javadtaghia/cece-the-robot/fun designs/samsung_t5_monitor_holder/T5_Left_Mount_Provisional.png

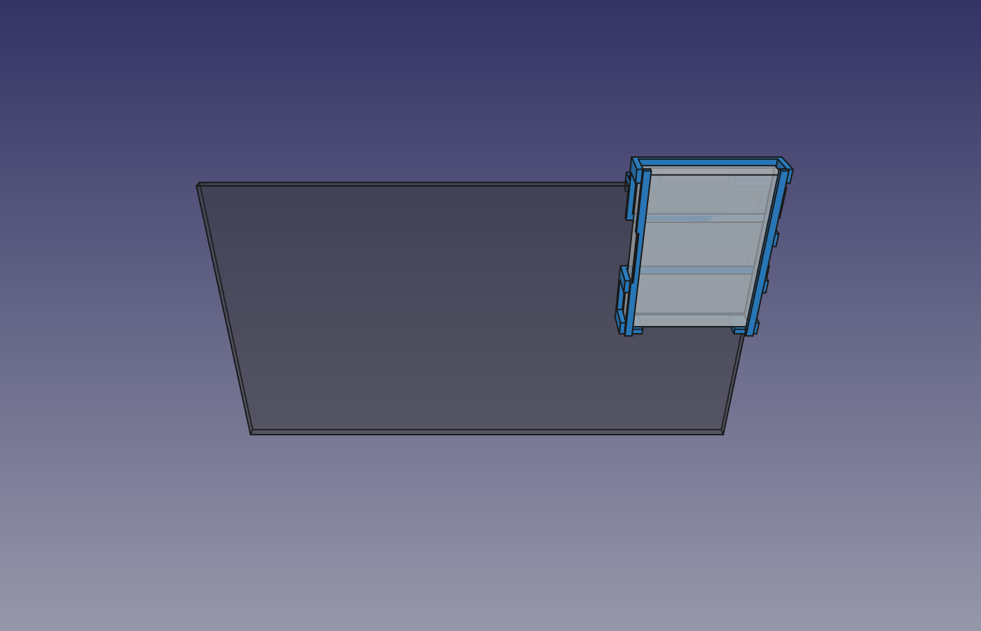
fun designs/samsung_t5_monitor_holder/T5_Left_Mount_Provisional.png
