javadtaghia/cece-the-robot/fun designs/samsung_t5_monitor_holder/T5_One_Piece_4_Hooks_Preview.png

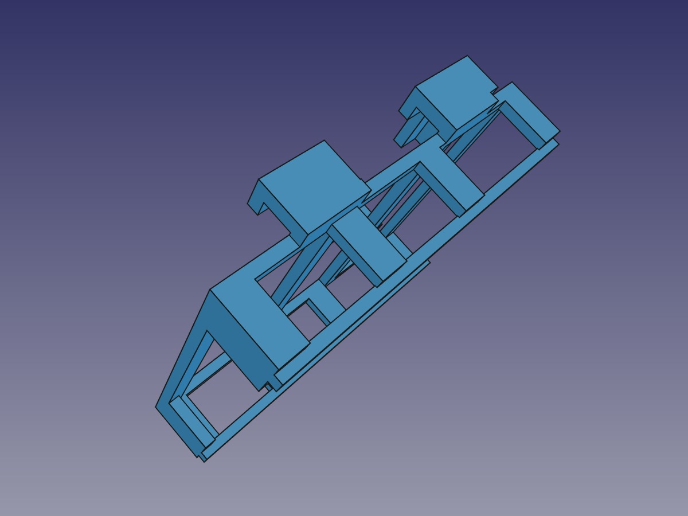
fun designs/samsung_t5_monitor_holder/T5_One_Piece_4_Hooks_Preview.png
