javadtaghia/cece-the-robot/fun designs/README.md

# Fun designs

- [Samsung T5 one-piece MacBook holder](samsung_t5_monitor_holder/README.md) — lightweight prototype with two loose side hooks and two top hooks. Real-laptop fit and load are unverified.
