javadtaghia/cece-the-robot/archive/workspace/piicodev_servo_ref/README.md

# PiicoDev® Servo Driver

This is the repo for the Core Electronics [PiicoDev Servo Driver](https://core-electronics.com.au/catalog/product/view/sku/CE09181) PCB project.

## License
This project is open source - please review the LICENSE.md file for further licensing information.

If you have any technical questions, or concerns about licensing, please contact technical support on the [Core Electronics forums](https://forum.core-electronics.com.au/).

*\"PiicoDev\" and the PiicoDev logo are trademarks of Core Electronics Pty Ltd.*
