javadtaghia/cece-the-robot/experiments/cece2/Cece2_Assembly.FCStd

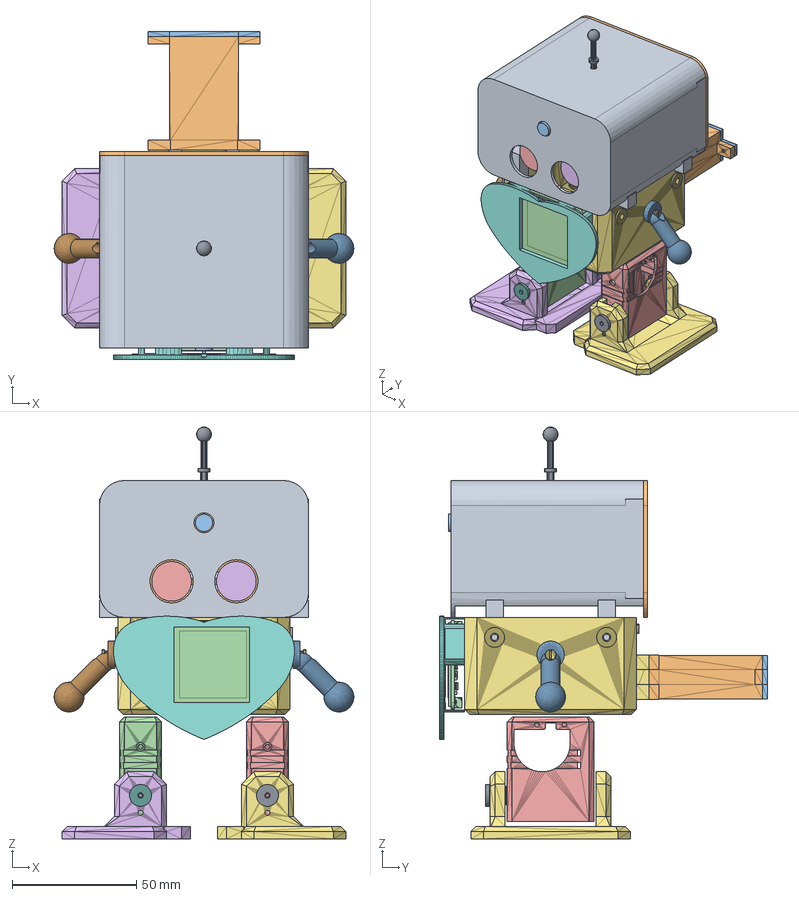
[picture p3: CAD file, 2026-11-01]
experiments/cece2/Cece2_Assembly.FCStd
120.4 x 131.7 x 165.5 mm
Rounded_Head_Study
Rear_Cover_Study
Camera_Lens_Corridor_Provisional
OLED_Adafruit4741_Official_CAD
HC_SR04_Left_Can
HC_SR04_Right_Can
Heart Frame V4 candidate
Antenna
Left_Arm
Right_Arm
Left_Leg
Right_Leg
Left_Foot
Right_Foot
Left_Washer
Right_Washer
Charger_Tray
Charger_Bezel
