javadtaghia/cece-the-robot/experiments/cece/esp_head_carrier/Cece_Head_ESP_Assembly_R10.FCStd

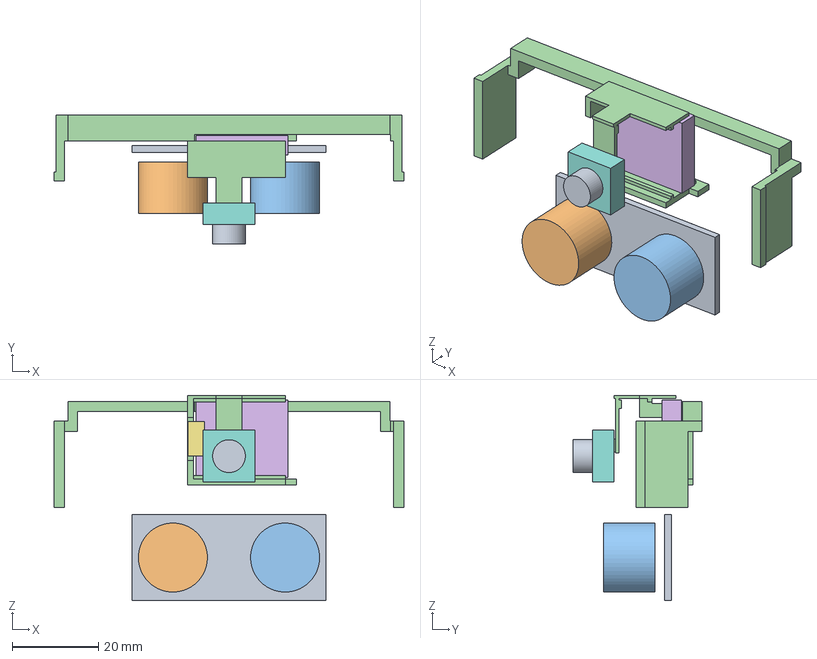
[picture p6: CAD file, 2026-11-11]
experiments/cece/esp_head_carrier/Cece_Head_ESP_Assembly_R10.FCStd
81.1 x 29.8 x 47.6 mm
HC_SR04_PCB
HC_SR04_Left_Can
HC_SR04_Right_Can
Cece R10 carrier - 2 mm deeper, central ridge flush
Camera housing contact pad - 0.20 mm provisional preload
ESP PCB - internal layout provisional
ESP USB Socket - internal layout provisional
ESP Camera Housing - internal layout provisional
ESP Camera Lens - internal layout provisional
