javadtaghia/cece-the-robot/experiments/cece/esp_head_carrier/Cece_Head_ESP_Assembly_R11.FCStd

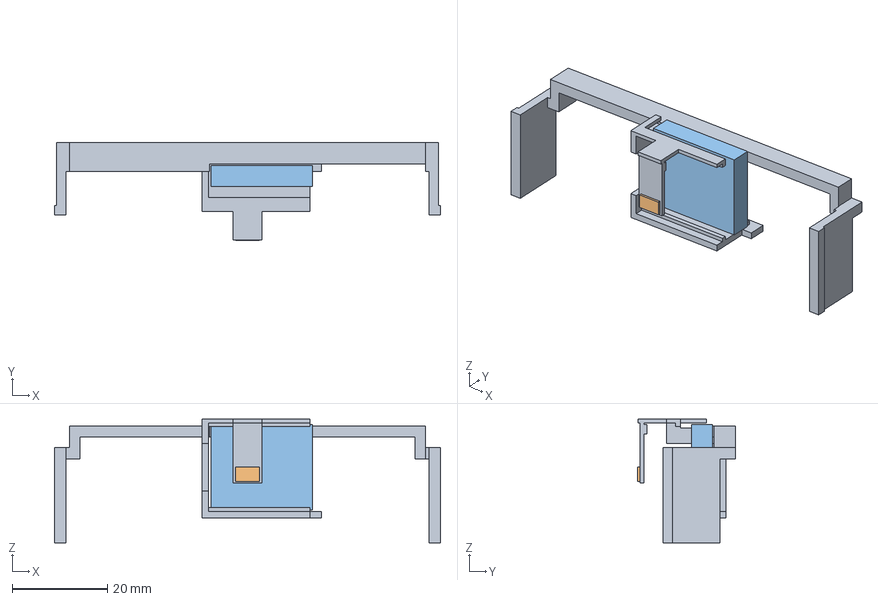
[picture p7: CAD file, 2026-11-11]
experiments/cece/esp_head_carrier/Cece_Head_ESP_Assembly_R11.FCStd
81.1 x 20.5 x 26.0 mm
Cece R11 carrier - open pin access above board
Camera housing contact pad - 0.20 mm provisional preload
ESP PCB - internal layout provisional
