javadtaghia/cece-the-robot/fun designs/samsung_t5_monitor_holder/Samsung_T5_Holder_Assembly_PROVISIONAL.FCStd

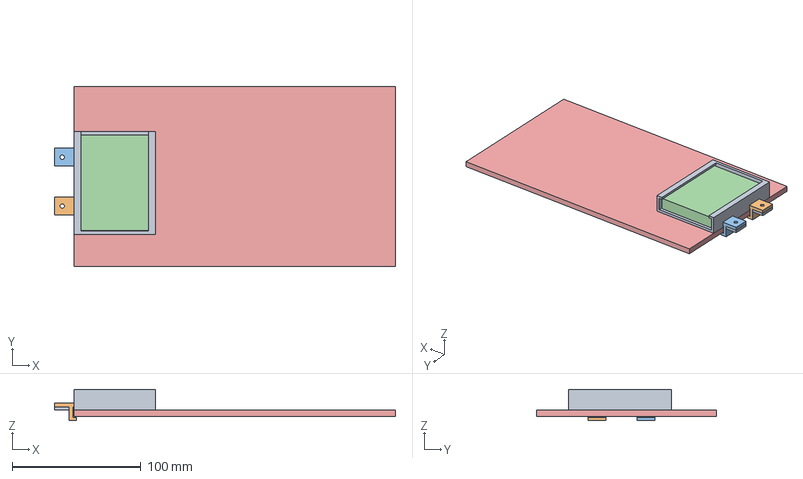
[picture p8: CAD file, 2026-10-31]
fun designs/samsung_t5_monitor_holder/Samsung_T5_Holder_Assembly_PROVISIONAL.FCStd
265.0 x 140.0 x 24.1 mm
Holder_print_one
Hook_lower_print_one
Hook_upper_print_one
SSD_envelope_reference_only
Monitor_envelope_reference_only
