javadtaghia/cece-the-robot/experiments/cece/esp_head_carrier/Cece_Head_ESP_Assembly_R15.FCStd

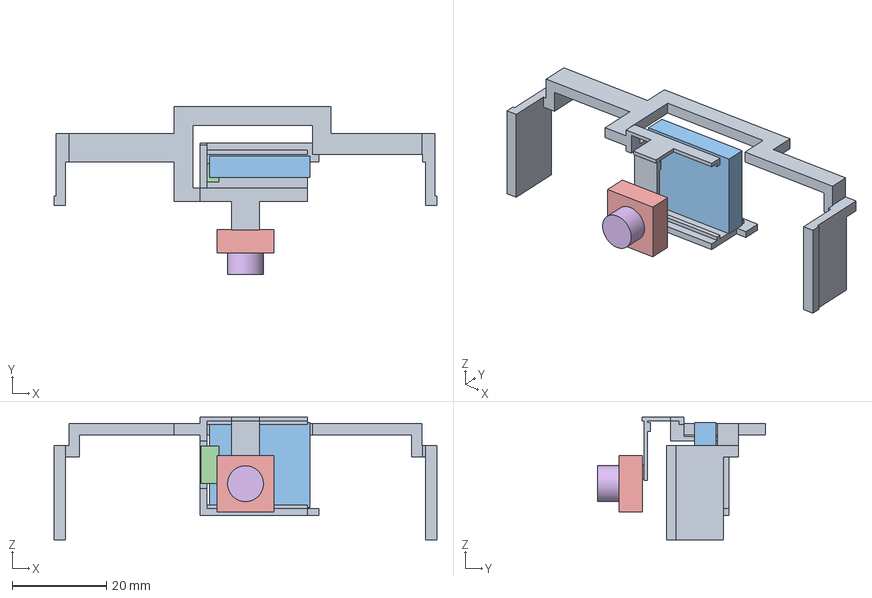
[picture p9: CAD file, 2026-11-11]
experiments/cece/esp_head_carrier/Cece_Head_ESP_Assembly_R15.FCStd
81.1 x 35.5 x 26.0 mm
Cece R15 carrier - screenshot-right shoulder shifted 3 mm
Camera housing contact pad - 0.20 mm provisional preload
ESP PCB - internal layout provisional
ESP USB Socket - internal layout provisional
ESP Camera Housing - internal layout provisional
ESP Camera Lens - internal layout provisional
