javadtaghia/cece-the-robot/experiments/cece/esp_head_carrier/Cece_Head_ESP_Assembly_R9.FCStd

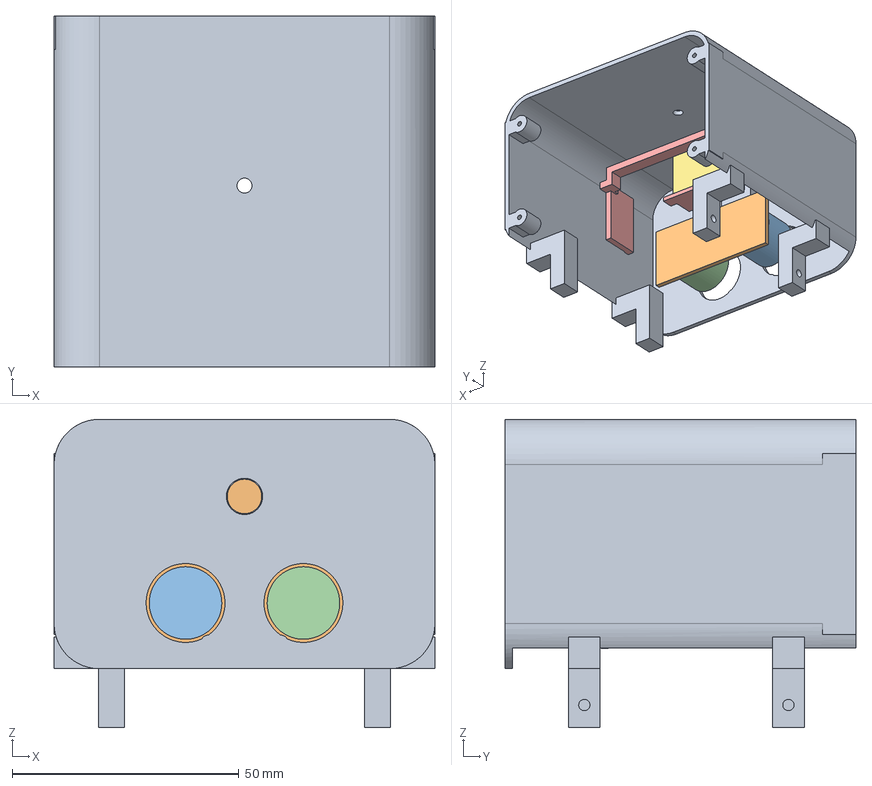
[picture p10: CAD file, 2026-11-11]
experiments/cece/esp_head_carrier/Cece_Head_ESP_Assembly_R9.FCStd
84.0 x 77.4 x 68.0 mm
Rounded_Head_Study
HC_SR04_PCB
HC_SR04_Left_Can
HC_SR04_Right_Can
Cece USB-first carrier - solid wall supports and camera flap
Camera housing contact pad - 0.20 mm provisional preload
ESP PCB - internal layout provisional
ESP USB Socket - internal layout provisional
ESP Camera Housing - internal layout provisional
ESP Camera Lens - internal layout provisional
