javadtaghia/cece-the-robot/experiments/cece/esp_head_carrier/Cece_Head_ESP_Assembly_R16.FCStd

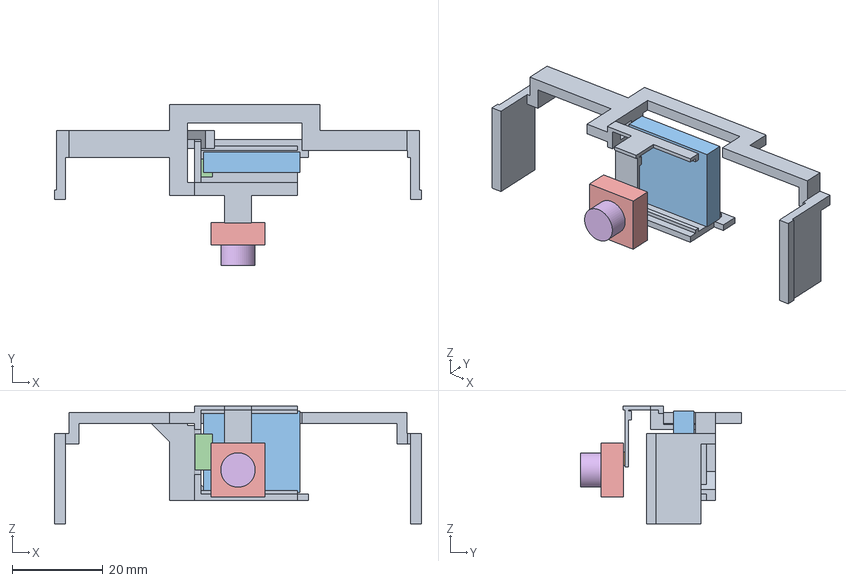
[picture p12: CAD file, 2026-11-08]
experiments/cece/esp_head_carrier/Cece_Head_ESP_Assembly_R16.FCStd
81.1 x 35.5 x 26.0 mm
Cece R16 carrier - reinforced USB-end upright
Camera housing contact pad - 0.20 mm provisional preload
ESP PCB - internal layout provisional
ESP USB Socket - internal layout provisional
ESP Camera Housing - internal layout provisional
ESP Camera Lens - internal layout provisional
