javadtaghia/cece-the-robot/experiments/cece/esp_head_carrier/Cece_Head_ESP_Assembly_R12.FCStd

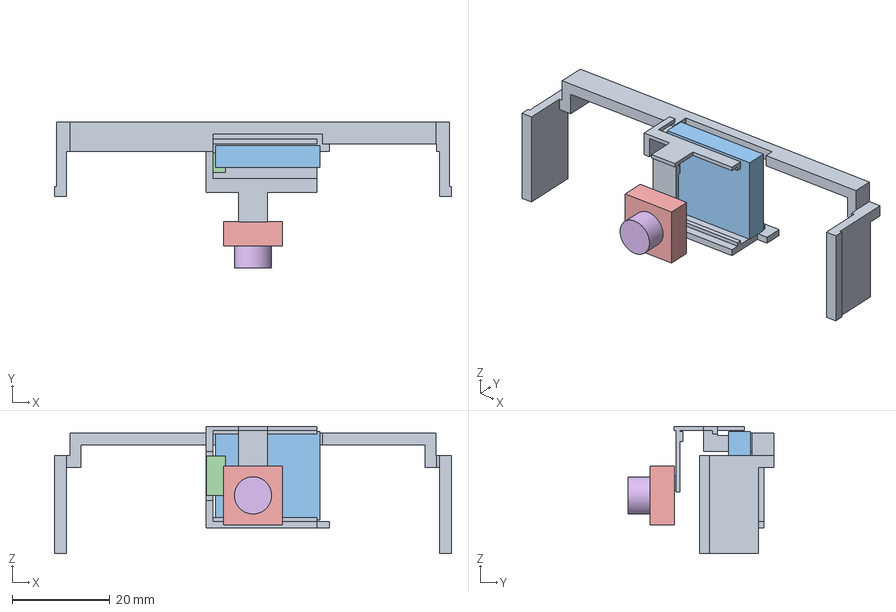
[picture p13: CAD file, 2026-11-08]
experiments/cece/esp_head_carrier/Cece_Head_ESP_Assembly_R12.FCStd
81.1 x 29.8 x 26.0 mm
Cece R12 carrier - ledge removed behind board edge
Camera housing contact pad - 0.20 mm provisional preload
ESP PCB - internal layout provisional
ESP USB Socket - internal layout provisional
ESP Camera Housing - internal layout provisional
ESP Camera Lens - internal layout provisional
