javadtaghia/cece-the-robot/experiments/cece/esp_head_carrier/Cece_Head_ESP_Assembly_R4.FCStd

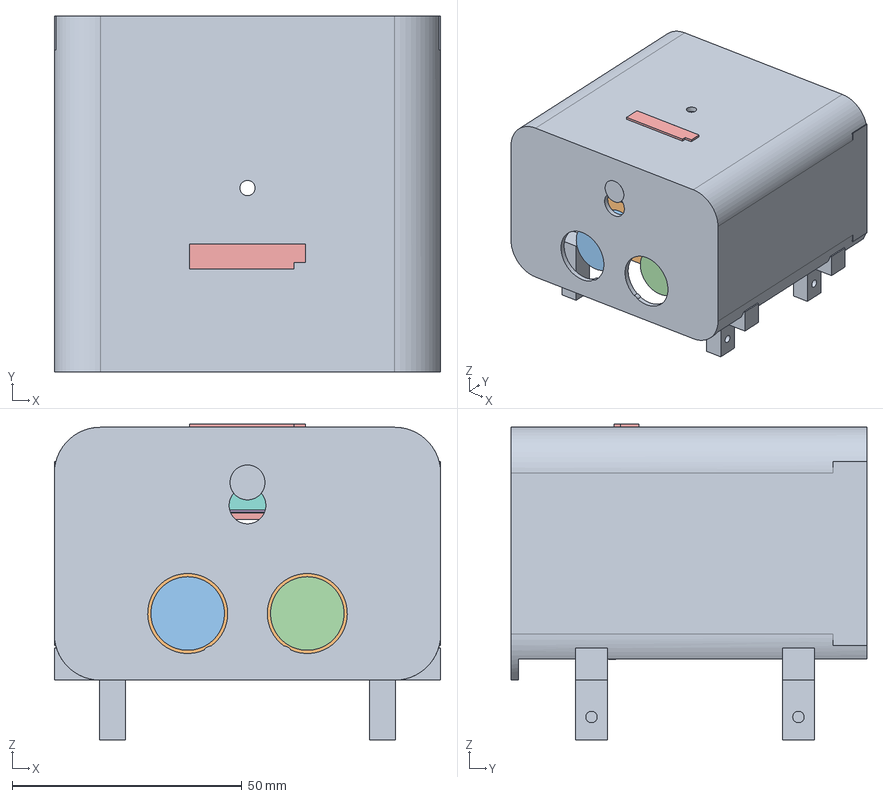
[picture p14: CAD file, 2026-11-08]
experiments/cece/esp_head_carrier/Cece_Head_ESP_Assembly_R4.FCStd
84.0 x 77.4 x 68.7 mm
Rounded_Head_Study
HC_SR04_PCB
HC_SR04_Left_Can
HC_SR04_Right_Can
Cece ESP carrier - reaches both inner side walls
ESP PCB - internal layout provisional
ESP USB Socket - internal layout provisional
ESP Camera Housing - internal layout provisional
ESP Camera Lens - internal layout provisional
REVIEW - raised carrier intersects current head
REVIEW - ESP Camera Lens intersects current head
