javadtaghia/cece-the-robot/experiments/cece/esp_head_carrier/Cece_Head_ESP_Assembly.FCStd

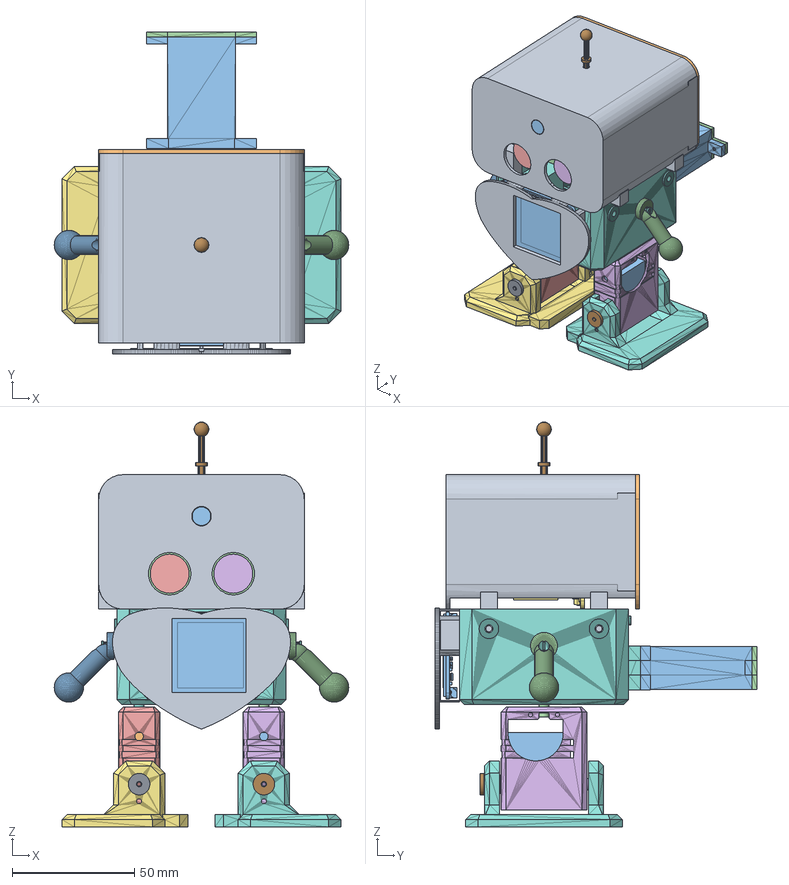
[picture p15: CAD file, 2026-11-07]
experiments/cece/esp_head_carrier/Cece_Head_ESP_Assembly.FCStd
120.4 x 131.7 x 165.5 mm
Rounded_Head_Study
Rear_Cover_Study
OLED_Adafruit4741_Official_CAD
HC_SR04_PCB
HC_SR04_Left_Can
HC_SR04_Right_Can
PiicoDev_Driver_Official_Partial_STEP
Left_Hip_SG90_Proxy
Right_Hip_SG90_Proxy
Left_Ankle_SG90_Proxy
Right_Ankle_SG90_Proxy
SG90_Mated_Plug_1_Proxy
SG90_Mated_Plug_2_Proxy
SG90_Mated_Plug_3_Proxy
SG90_Mated_Plug_4_Proxy
Heart Frame V4 candidate
Antenna
Left_Arm
Right_Arm
Left_Leg
Right_Leg
Left_Foot
Right_Foot
Left_Washer
Right_Washer
Charger_Tray
Charger_Bezel
Charger_UC2_Unpurchased_Proxy
Perfboard_Provisional_30x20
Left_Hip_Turret_Proxy
Left_Hip_Output_Shaft_Proxy
Left_Ankle_Turret_Proxy
Left_Ankle_Output_Shaft_Proxy
Right_Hip_Turret_Proxy
Right_Hip_Output_Shaft_Proxy
Right_Ankle_Turret_Proxy
Right_Ankle_Output_Shaft_Proxy
Cece ESP carrier - reaches both inner side walls
ESP PCB - internal layout provisional
ESP USB Socket - internal layout provisional
ESP Camera Housing - internal layout provisional
ESP Camera Lens - internal layout provisional
