javadtaghia/cece-the-robot/experiments/cece/esp_head_carrier/Cece_ESP_Side_Carrier_R14_PREVIEW.stl

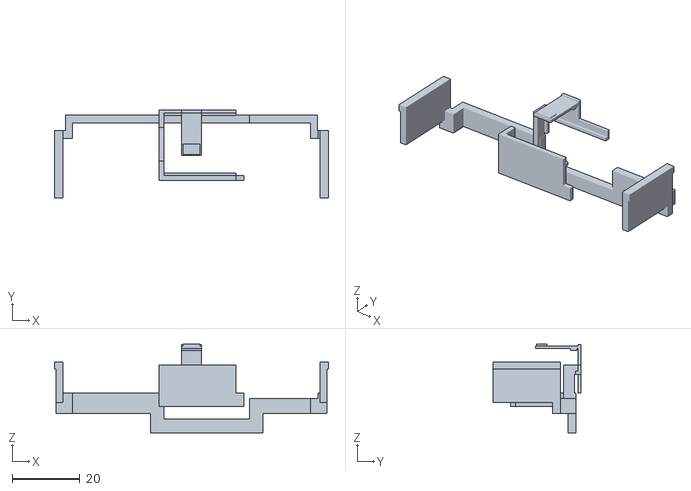
[picture p16: CAD file, 2026-11-11]
experiments/cece/esp_head_carrier/Cece_ESP_Side_Carrier_R14_PREVIEW.stl
81.1 x 26.0 x 26.2
