javadtaghia/cece-the-robot/fun designs/samsung_t5_monitor_holder/Samsung_T5_One_Piece_Prototype.FCStd

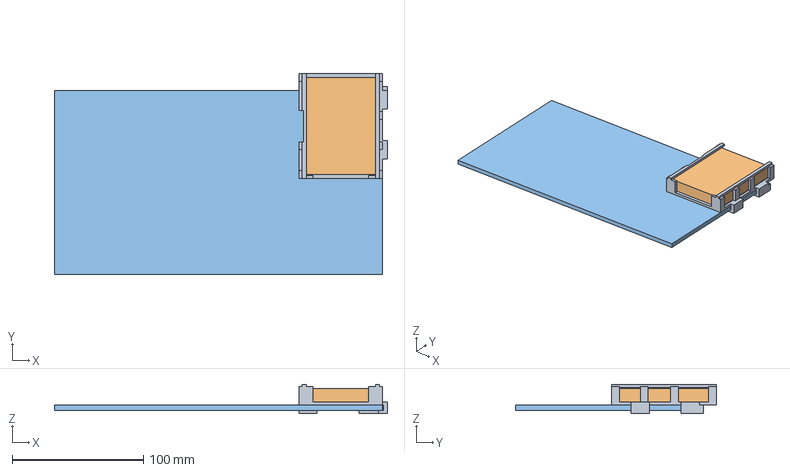
[picture p17: CAD file, 2026-11-07]
fun designs/samsung_t5_monitor_holder/Samsung_T5_One_Piece_Prototype.FCStd
253.8 x 153.0 x 22.3 mm
Holder_one_piece_PRINT
SSD_reference_do_not_print
Lid_reference_do_not_print
