javadtaghia/cece-the-robot/fun designs/samsung_t5_monitor_holder/T5_One_Piece_Holder_PROTOTYPE.3mf

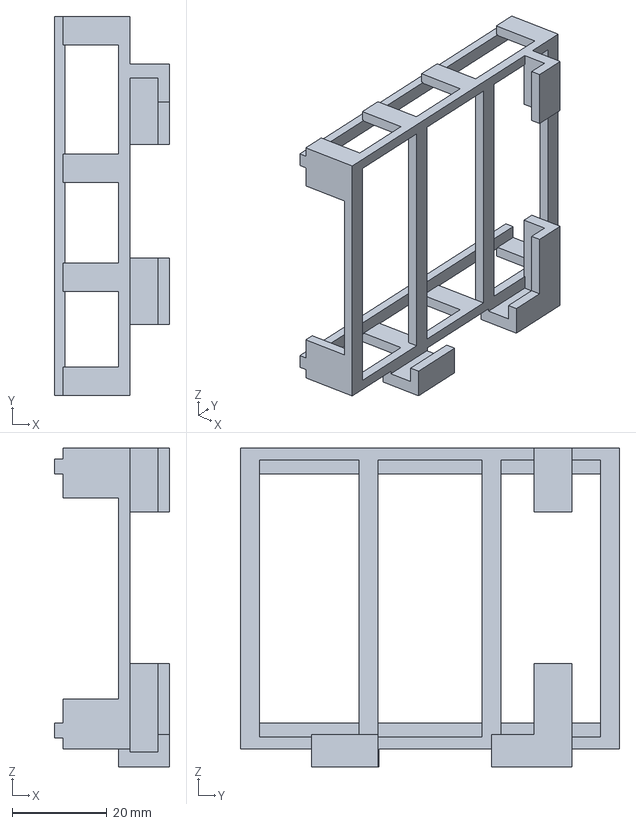
[picture p18: CAD file, 2026-10-31]
fun designs/samsung_t5_monitor_holder/T5_One_Piece_Holder_PROTOTYPE.3mf
24.3 x 80.0 x 67.3 mm
