javadtaghia/cece-the-robot/fun designs/samsung_t5_monitor_holder/Upper_corner_support_print_1_PROVISIONAL.stl

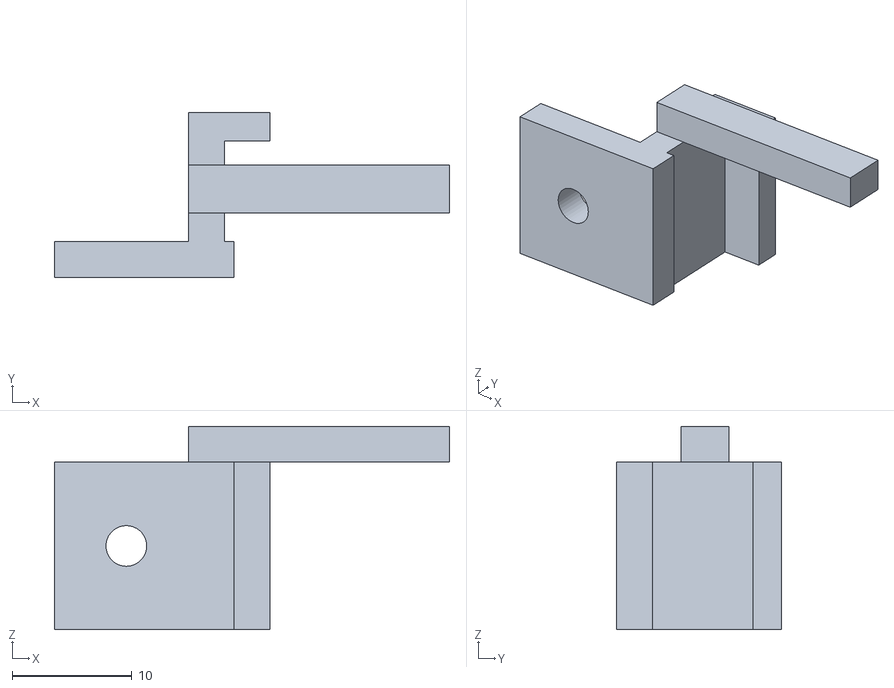
[picture p19: CAD file, 2026-10-31]
fun designs/samsung_t5_monitor_holder/Upper_corner_support_print_1_PROVISIONAL.stl
33.0 x 13.8 x 17.0
