javadtaghia/cece-the-robot/fun designs/samsung_t5_monitor_holder/Lower_side_hook_print_1_PROVISIONAL.stl

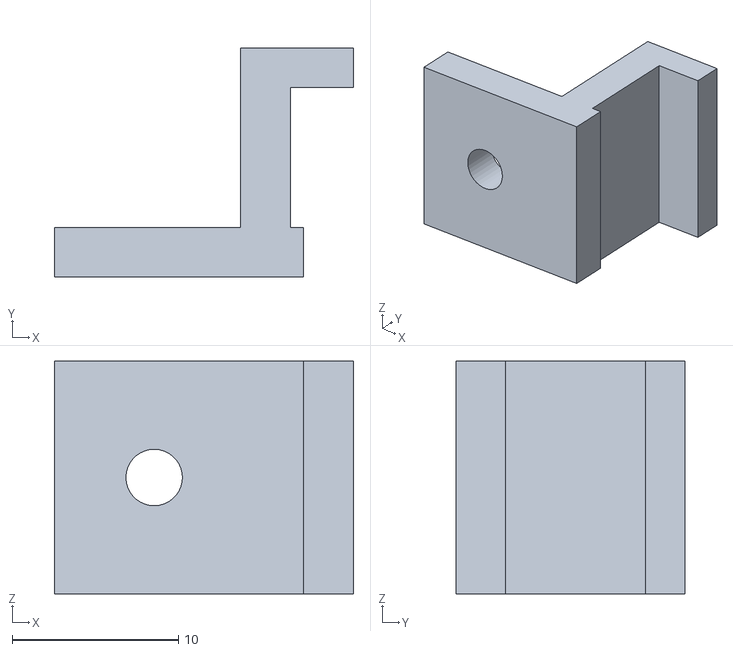
[picture p20: CAD file, 2026-10-31]
fun designs/samsung_t5_monitor_holder/Lower_side_hook_print_1_PROVISIONAL.stl
18.0 x 13.8 x 14.0
