javadtaghia/cece-the-robot/fun designs/samsung_t5_monitor_holder/Monitor_hook_print_2_PROVISIONAL.stl

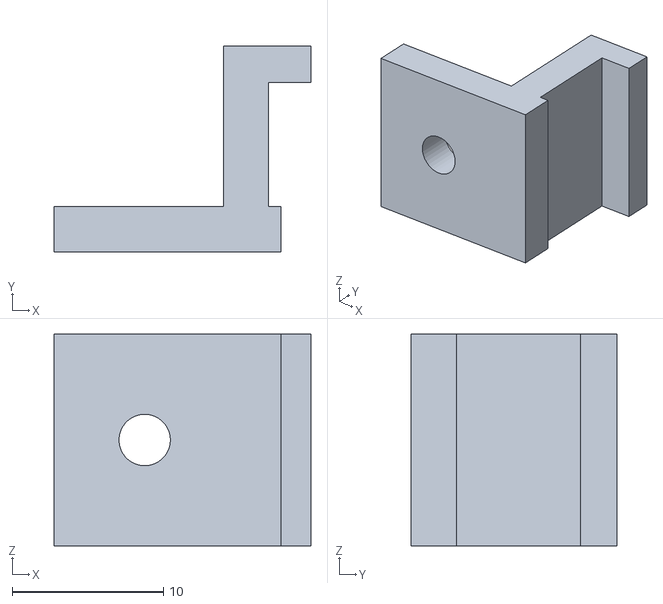
[picture p21: CAD file, 2026-10-31]
fun designs/samsung_t5_monitor_holder/Monitor_hook_print_2_PROVISIONAL.stl
17.0 x 13.6 x 14.0
