javadtaghia/cece-the-robot/fun designs/samsung_t5_monitor_holder/T5_holder_print_1_PROVISIONAL.stl

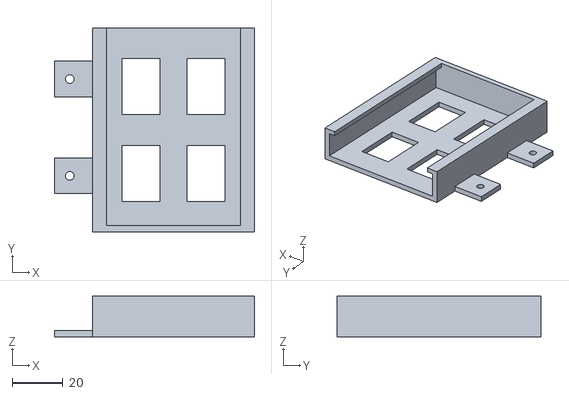
[picture p22: CAD file, 2026-10-31]
fun designs/samsung_t5_monitor_holder/T5_holder_print_1_PROVISIONAL.stl
78.5 x 80.0 x 15.9
