javadtaghia/cece-the-robot/experiments/cece/esp_head_carrier/Cece_ESP_Support_R16_Reinforced_PLA_TEST_FIT.3mf

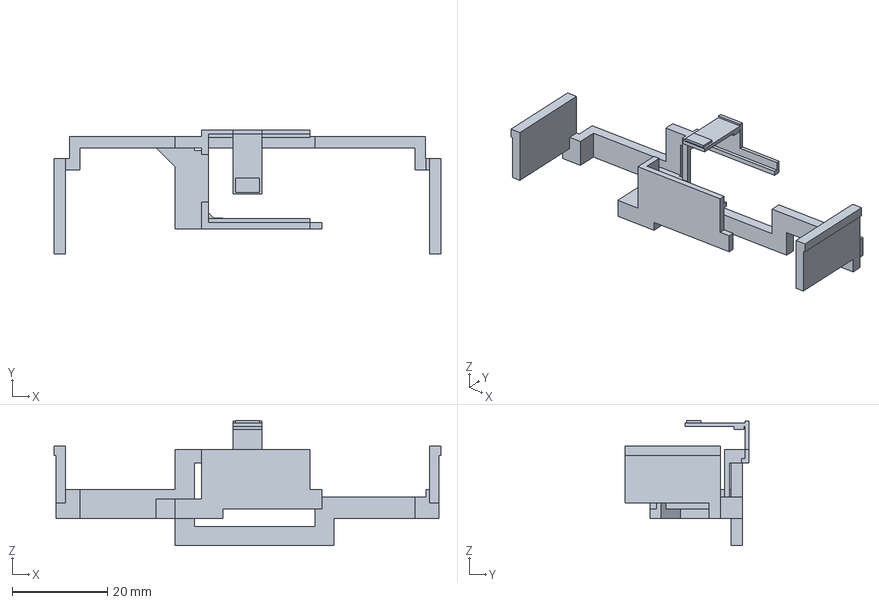
[picture p23: CAD file, 2026-11-08]
experiments/cece/esp_head_carrier/Cece_ESP_Support_R16_Reinforced_PLA_TEST_FIT.3mf
81.1 x 26.0 x 26.2 mm
