javadtaghia/cece-the-robot/experiments/cece/esp_head_carrier/Cece_ESP_Side_Carrier_R11_PREVIEW.stl

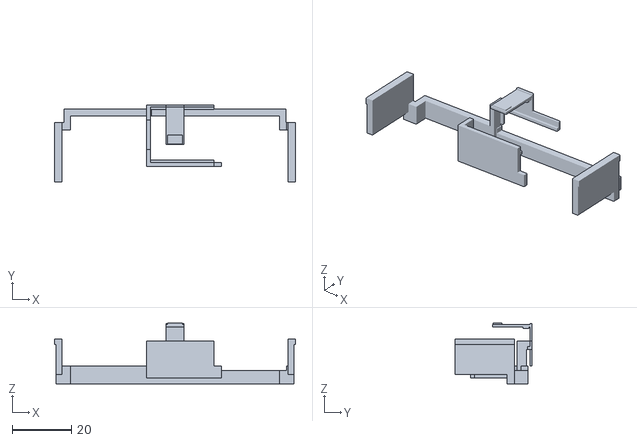
[picture p26: CAD file, 2026-11-08]
experiments/cece/esp_head_carrier/Cece_ESP_Side_Carrier_R11_PREVIEW.stl
81.1 x 26.0 x 20.5
