javadtaghia/cece-the-robot/experiments/cece/esp_head_carrier/Cece_ESP_Support_R8_Light_PLA_TEST_FIT.3mf

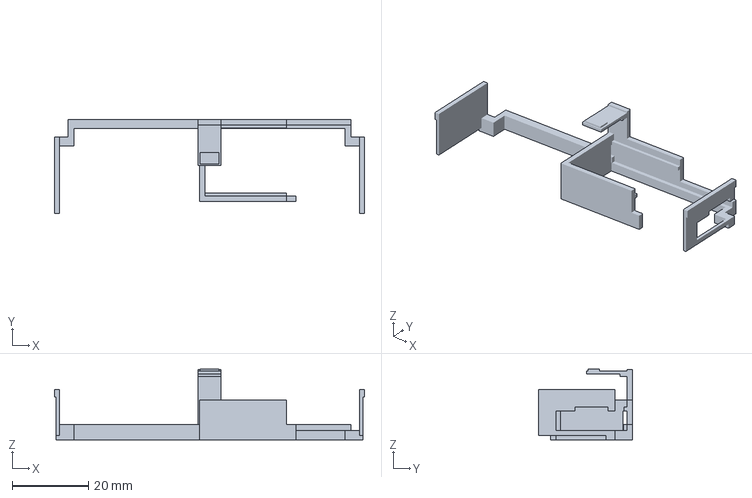
[picture p28: CAD file, 2026-11-08]
experiments/cece/esp_head_carrier/Cece_ESP_Support_R8_Light_PLA_TEST_FIT.3mf
81.1 x 24.6 x 18.5 mm
