javadtaghia/cece-the-robot/experiments/cece/esp_head_carrier/Cece_ESP_Support_R7_Light_PLA_TEST_FIT.3mf

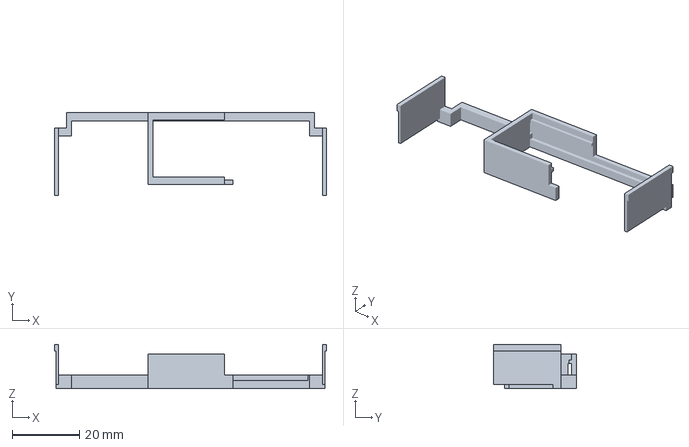
[picture p30: CAD file, 2026-11-08]
experiments/cece/esp_head_carrier/Cece_ESP_Support_R7_Light_PLA_TEST_FIT.3mf
81.1 x 24.6 x 13.2 mm
