javadtaghia/cece-the-robot/experiments/cece/esp_head_carrier/Cece_ESP_Side_Carrier_R8_PREVIEW.stl

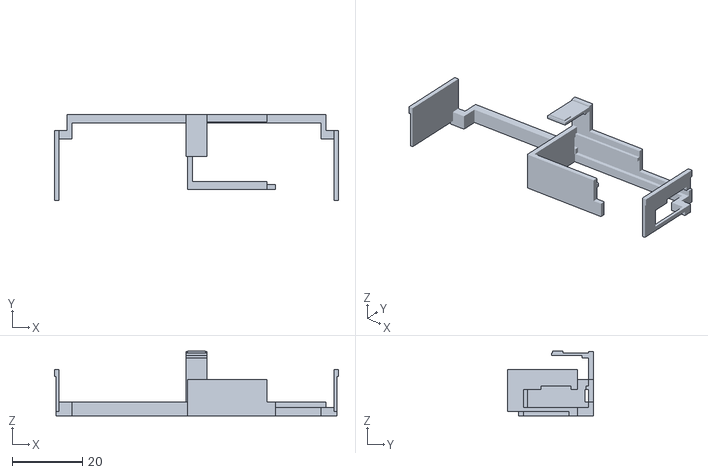
[picture p31: CAD file, 2026-11-08]
experiments/cece/esp_head_carrier/Cece_ESP_Side_Carrier_R8_PREVIEW.stl
81.1 x 24.6 x 18.5
