javadtaghia/cece-the-robot/experiments/cece/esp_head_carrier/Cece_ESP_Side_Carrier_R4_REVIEW_ONLY.stl

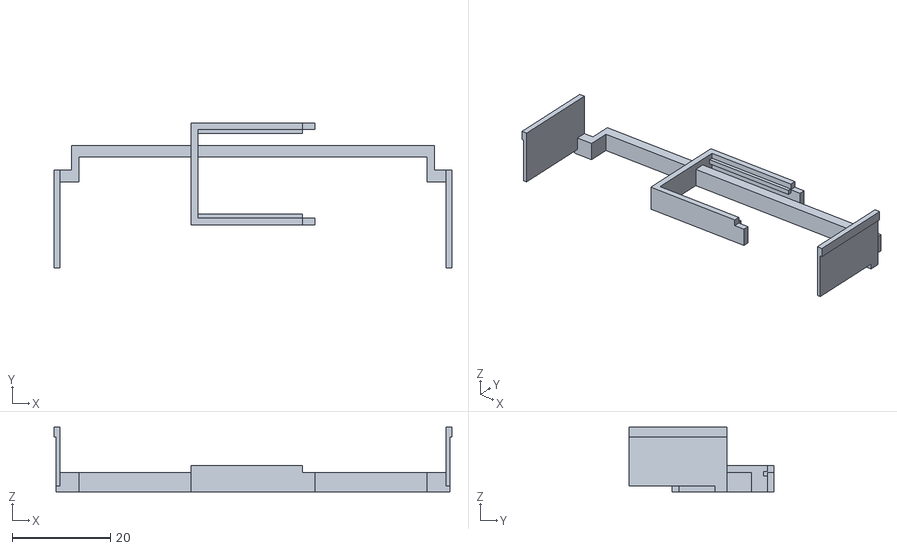
[picture p32: CAD file, 2026-11-08]
experiments/cece/esp_head_carrier/Cece_ESP_Side_Carrier_R4_REVIEW_ONLY.stl
81.1 x 29.6 x 13.2
