javadtaghia/cece-the-robot/experiments/cece/esp_head_carrier/Cece_ESP_Side_Carrier_R3_TEST_FIT.stl

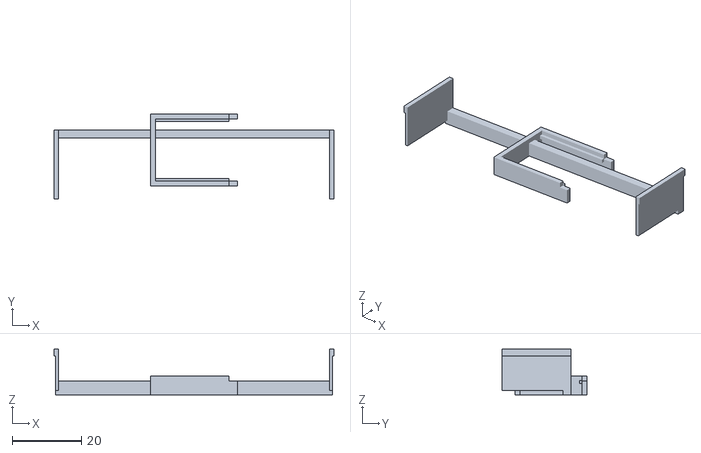
[picture p33: CAD file, 2026-11-08]
experiments/cece/esp_head_carrier/Cece_ESP_Side_Carrier_R3_TEST_FIT.stl
81.1 x 24.6 x 13.2
