javadtaghia/cece-the-robot/experiments/cece/esp_head_carrier/Cece_ESP_Support_R2_Light_PLA_TEST_FIT.3mf

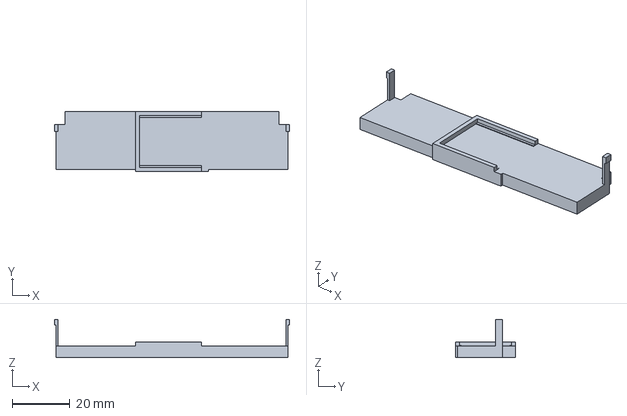
[picture p34: CAD file, 2026-11-08]
experiments/cece/esp_head_carrier/Cece_ESP_Support_R2_Light_PLA_TEST_FIT.3mf
81.1 x 20.8 x 13.2 mm
