javadtaghia/cece-the-robot/experiments/cece/esp_head_carrier/Cece_ESP_Support_Light_PLA_TEST_FIT.3mf

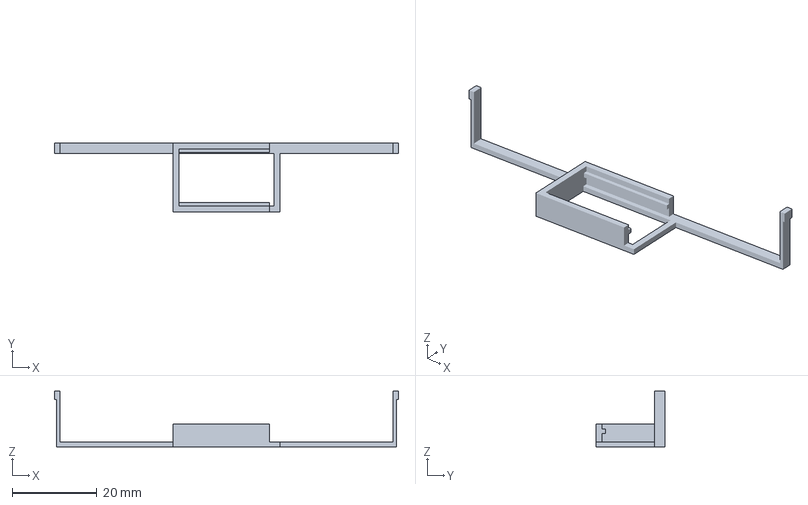
[picture p35: CAD file, 2026-11-07]
experiments/cece/esp_head_carrier/Cece_ESP_Support_Light_PLA_TEST_FIT.3mf
81.1 x 16.2 x 13.2 mm
