javadtaghia/cece-the-robot/experiments/cece/esp_head_carrier/Cece_ESP_Board_Cradle_TEST_FIT.FCStd

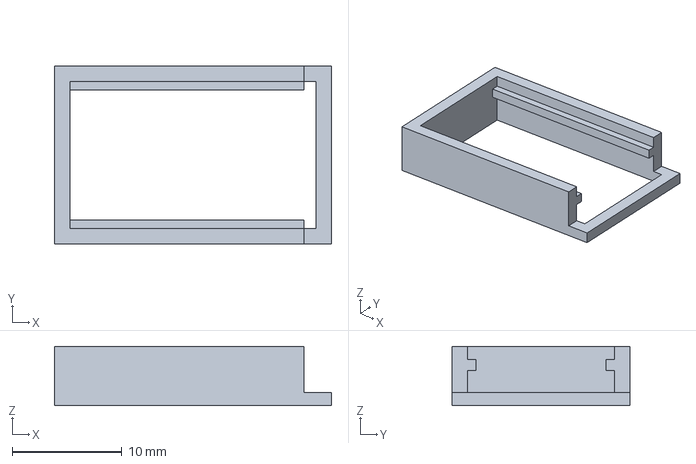
[picture p36: CAD file, 2026-11-07]
experiments/cece/esp_head_carrier/Cece_ESP_Board_Cradle_TEST_FIT.FCStd
25.2 x 16.2 x 5.40 mm
