javadtaghia/cece-the-robot/(list of files, cad)

Other CAD files:
experiments/cece/esp_head_carrier/Cece_Head_ESP_Assembly_R14.FCStd
experiments/cece/esp_head_carrier/Cece_Head_ESP_Assembly_R8.FCStd
experiments/cece/esp_head_carrier/Cece_Head_ESP_Assembly_R6.FCStd
experiments/cece/esp_head_carrier/Cece_Head_ESP_Assembly_R5.FCStd
experiments/cece/esp_head_carrier/Cece_Head_ESP_Assembly_R2.FCStd
experiments/cece/esp_head_carrier/Cece_ESP_Side_Carrier_R16_PREVIEW.stl
experiments/cece/esp_head_carrier/Cece_ESP_Side_Carrier_R15_PREVIEW.stl
experiments/cece/esp_head_carrier/Cece_ESP_Side_Carrier_R13_PREVIEW.stl
experiments/cece/esp_head_carrier/Cece_ESP_Support_R9_Light_PLA_TEST_FIT.3mf
experiments/cece/esp_head_carrier/Cece_ESP_Side_Carrier_R9_PREVIEW.stl
experiments/cece/esp_head_carrier/Cece_ESP_Side_Carrier_R7_PREVIEW.stl
experiments/cece/esp_head_carrier/Cece_ESP_Side_Carrier_R5_TEST_FIT.stl
experiments/cece/esp_head_carrier/Cece_ESP_Side_Carrier_R2_TEST_FIT.stl
experiments/cece/esp_head_carrier/Cece_ESP_Side_Carrier_CANDIDATE.stl
archive/workspace/chick_drive_rig.scad
archive/workspace/chick_concept.scad
archive/workspace/chick_crank_rig.scad
archive/workspace/chick_packaging.scad
archive/workspace/Cece_Prototype_Plate/Heart_Frame_V3.stl
archive/workspace/Cece_Prototype_Plate/Left_Washer.stl
archive/workspace/Cece_Prototype_Plate/Right_Washer.stl
archive/workspace/Cece_Prototype_Plate/Rounded_Head_Study.stl
archive/workspace/Otto_Simple_Print/Otto_Simple_PLA_H2S.3mf
archive/workspace/cece_ankle_v2/Cece_SG90_Ankle_V2.FCStd
archive/workspace/freecad_cece/CeCe_PLA_Prototype.FCStd
archive/workspace/freecad_cece/stl/Head_rear_cover.stl
archive/workspace/freecad_cece/stl/Head_shell.stl
archive/workspace/freecad_cece/stl/Heart_badge.stl
archive/workspace/freecad_cece/stl/Left_arm.stl
archive/workspace/freecad_cece/stl/Left_foot.stl
archive/workspace/freecad_cece/stl/Neck_channel.stl
archive/workspace/freecad_cece/stl/Right_arm.stl
archive/workspace/freecad_cece/stl/Right_foot.stl
archive/workspace/freecad_cece/stl/Right_leg_blank.stl
archive/workspace/freecad_cece/stl/Torso_shell.stl
archive/workspace/freecad_cece_components/CeCe_Component_Study.FCStd
archive/workspace/freecad_cece_components/CeCe_Separate_Pieces.FCStd
archive/workspace/freecad_cece_components/stl/Antenna.stl
archive/workspace/freecad_cece_components/stl/Head_shell.stl
archive/workspace/freecad_cece_components/stl/Left_foot.stl
archive/workspace/freecad_cece_components/stl/Left_leg_blank.stl
archive/workspace/freecad_cece_components/stl/Neck_rear_strip.stl
archive/workspace/freecad_cece_components/stl/Right_arm.stl
archive/workspace/freecad_cece_components/stl/Right_foot.stl
archive/workspace/freecad_cece_components/stl/Right_leg_blank.stl
archive/workspace/freecad_cece_components/stl/Torso_shell.stl
archive/workspace/freecad_cece_v2/CeCe_Actuator_Study.FCStd
archive/workspace/freecad_cece_v2/stl/Head_rear_cover.stl
archive/workspace/freecad_cece_v2/stl/Left_arm.stl
archive/workspace/freecad_cece_v2/stl/Left_leg_blank.stl
archive/workspace/freecad_cece_v2/stl/Torso_rear_cover.stl
archive/workspace/freecad_cece_v2/stl/Torso_shell.stl
archive/workspace/otto_reference/CAD/OttoDIY_FreeCad.fcstd
archive/workspace/out/sole.obj
experiments/cece/esp_head_carrier/Cece_ESP_Board_Cradle_TEST_FIT.stl
fun designs/samsung_t5_monitor_holder/T5_One_Piece_Holder_PROTOTYPE.stl
fun designs/samsung_t5_monitor_holder/previous_multi_piece/Samsung_T5_Holder_Assembly_PROVISIONAL.FCStd
