javadtaghia/cece-the-robot/archive/workspace/Otto_Simple_Print/PRINT_GUIDE.txt

Simple Otto DIY V9 print set

Print quantities:
- OttoDIY_head_V9.stl: 1
- OttoDIY_body_V9.stl: 1
- OttoDIY_Leg_V9.stl: 2
- OttoDIY_foot_V9.stl: 2

Use millimetres and 100% scale in your slicer.
The included upstream README recommends PLA, 0.20 mm layers, at least 20% infill, and no supports or rafts.

Original files copied without modification from the local otto_reference/3Dprint folder.
Source: Otto DIY, https://github.com/Open-Hardware-Leaders/OttoDIY
See UPSTREAM_README.md for original attribution and project details.
