javadtaghia/cece-the-robot/experiments/bench_tests/arduino_due_sg90/Due_Four_SG90_Wiring.png

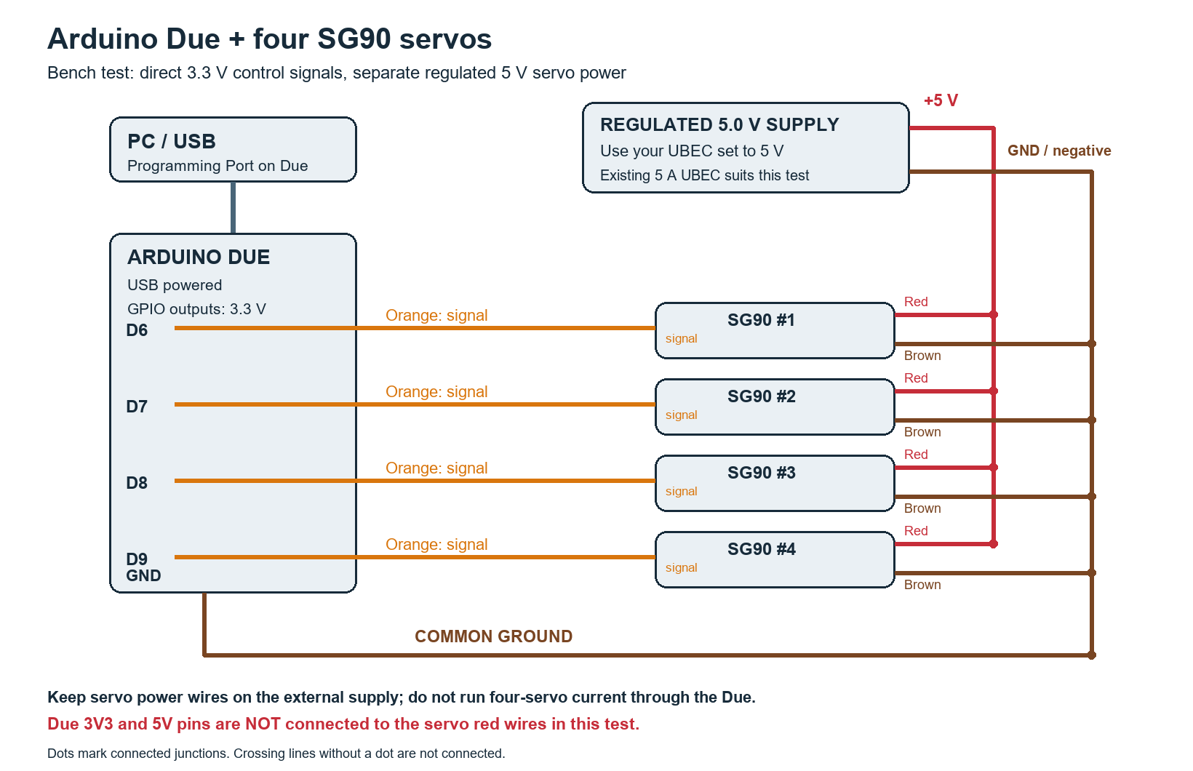
experiments/bench_tests/arduino_due_sg90/Due_Four_SG90_Wiring.png
