javadtaghia/cece-the-robot/experiments/cece/electronics/kicad_s3_bench/preview/Cece_USB_Bench_Wiring-Ultrasonic.png

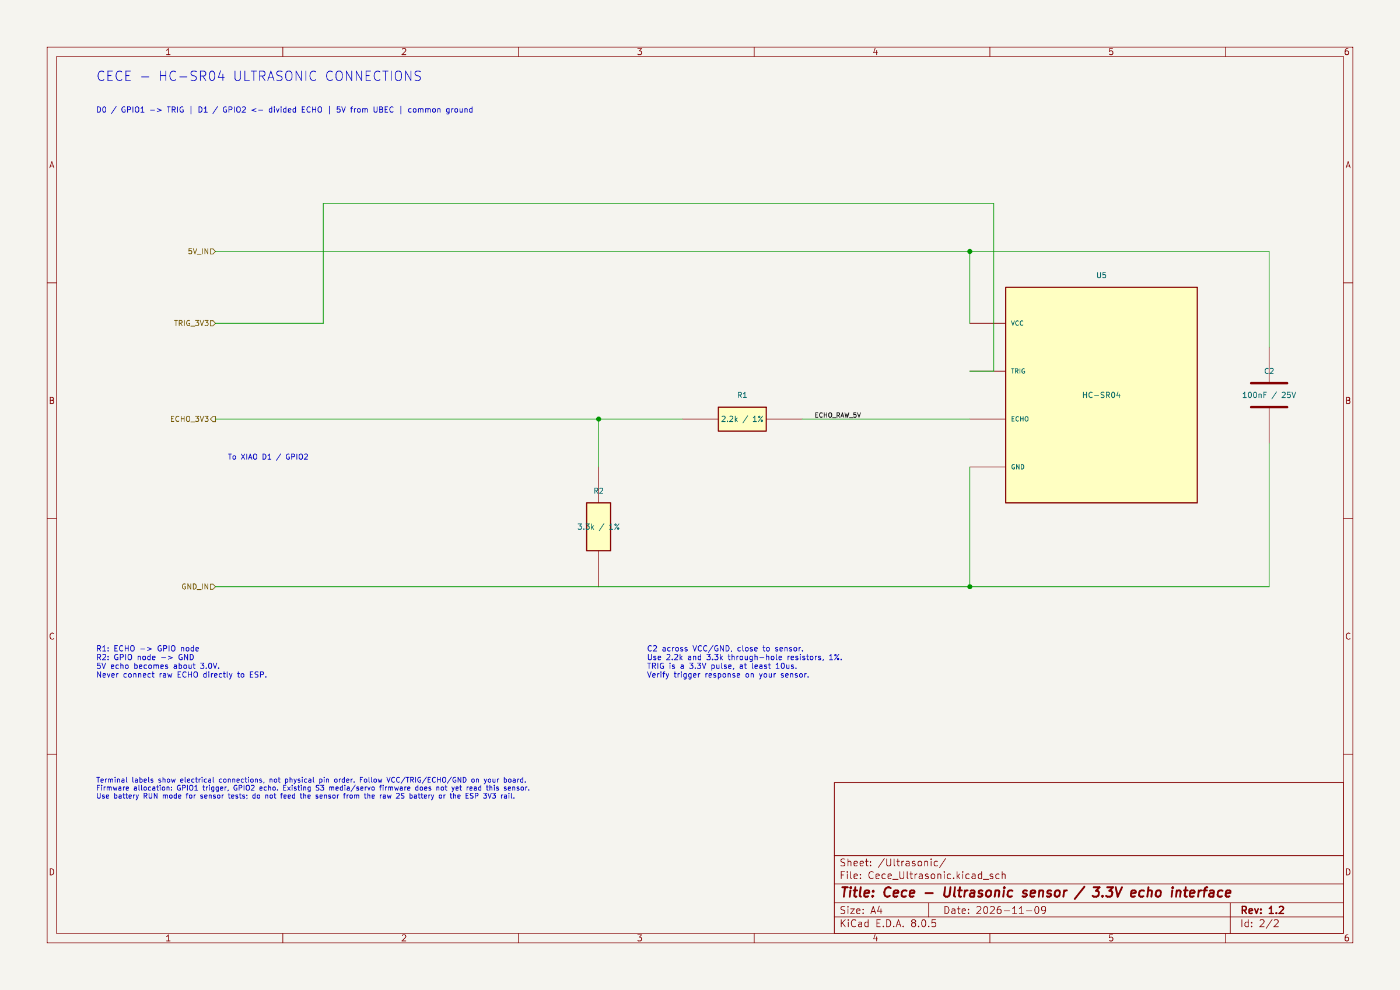
experiments/cece/electronics/kicad_s3_bench/preview/Cece_USB_Bench_Wiring-Ultrasonic.png
