javadtaghia/cece-the-robot/experiments/cece/esp_head_carrier/Cece_Assembly_With_ESP_R2.png

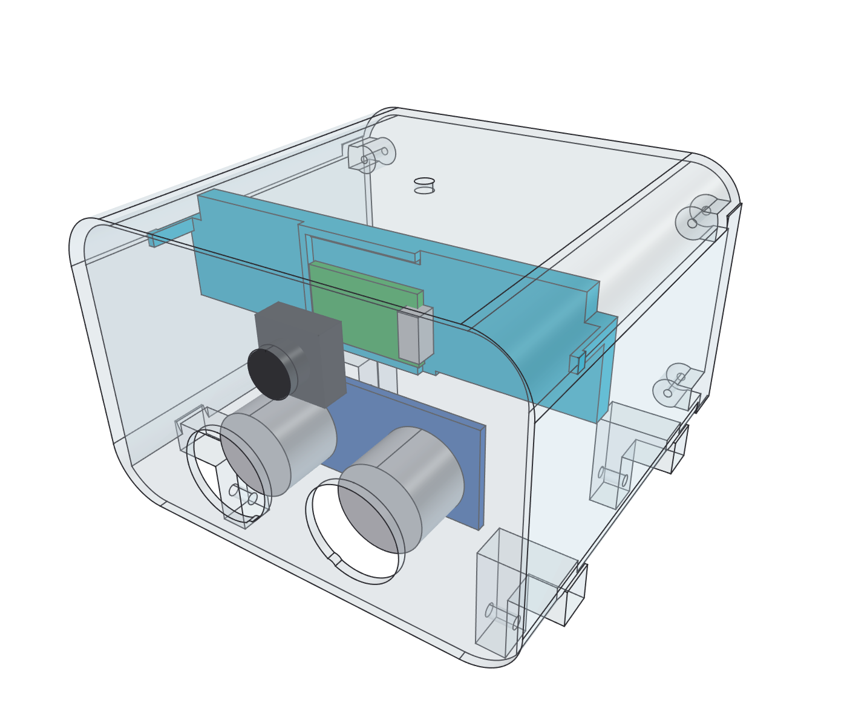
experiments/cece/esp_head_carrier/Cece_Assembly_With_ESP_R2.png
