javadtaghia/cece-the-robot/experiments/cece/ros2_sim/README.md

# Cece ROS 2 and Gazebo study

For the complete Windows start-up sequence, including Wokwi, voice and AtBots,
see [Start Cece's simulation](../START_HERE.md).

The starter world is a 4 m by 4 m virtual room with a floor, four walls and a
box obstacle. It is invented geometry, not a scan or measurement of a real
room. The XML can be inspected with any SDF-compatible tool.

On Ubuntu 24.04 with ROS 2 Jazzy and Gazebo Harmonic installed:

```bash
source /opt/ros/jazzy/setup.bash
gz sim -r worlds/starter_room.sdf
```

To generate and view the provisional Cece model in the room:

```bash
python3 build_prototype_world.py
gz sim generated/starter_cece.sdf
```

The model uses existing CAD visuals, estimated component masses, simple box
colliders and approximate box inertias. Four Gazebo position controllers and
an experimental gait are provided:

```bash
source /opt/ros/jazzy/setup.bash
python3 walk_controller.py --steps 20
python3 evaluate_gait.py
```

Each requested step corresponds to one alternating commanded half-step.
If no count is specified, motion continues until a stop request. The PC bridge
accepts requests such as “move forward twenty steps” without a fixed maximum;
say “stop” to request a stop. Asking to “move forward faster” selects a
shorter 0.4-second phase instead of 0.8 seconds; this is an experimental
command rate, not a measured walking speed. Backward and turning joint sequences are experimental; in Gazebo tests they
produced opposite displacement and opposite rotation, respectively. They have
not established physical walking or reliable navigation. It responds once the request has been launched,
not when motion finishes. The stop request applies to the Gazebo gait only.

The evaluation measured all four joints moving and roughly 15 mm of body
displacement in one run. Reported foot-frame vertical ranges were under
0.001 mm: this does not demonstrate foot lift and suggests sliding. The
script does not measure ground contact or landing, and cannot establish
walking. The previous
`../bullet_gait` study uses different contact geometry and assumptions.
The PC bridge can explicitly enable a simulation-only gait in response to a
request from the ESP32; it launches the Gazebo controller directly. This is
not a simulation of the ESP32's PCA9685 outputs driving Gazebo joints.
This world cannot establish physical walking, obstacle detection, real-world
mapping, servo fit or electrical safety. Camera hardware and actual room data
are still needed for a real reconstruction.

## Intended connections

The ESP32 remains responsible for its real sensor and motor firmware. It will
send audio or commands over Wi-Fi to a PC service rather than running the
large language model locally. The PC service can use AtBots and the user's
own authorized ChatGPT plan for text; weather comes from a weather service.
ROS 2 will coordinate robot state and commands, and Gazebo will model the
robot, sensors and room. A direct Wokwi servo-output-to-ROS bridge still has
to be written and tested. ChatGPT plan OAuth does not provide simulated I2S audio,
and its preview route does not support audio or transcription; speech needs
an additional supported speech path.

## Sensor work in progress

The generated Gazebo world publishes a 320 × 240 camera image on
`/cece/camera/image` and a narrow five-ray range approximation on
`/cece/range_scan`. The assumed forward direction is -Y and needs physical
verification. The range model is lidar-style geometry, not an HC-SR04
electrical, acoustic or firmware simulation. The camera and range topics were
observed publishing in a headless test. The PC-side autonomous experiment checks that the camera stream is live and
uses the range scan to stop forward commands and try a left turn when an
obstacle is within 0.5 m. It stops if sensor messages go stale and stops after
eight blocked turns. The camera is not used for visual obstacle recognition.
The range model and controller do not run in ESP32 firmware. One headless
scenario with an obstacle approximately 0.25 m ahead was tested; this is not
a general obstacle avoidance or physical safety validation.

## View the simulated camera

With Gazebo running, in this directory in Ubuntu run:

```bash
source /opt/ros/jazzy/setup.bash
python3 camera_view.py
```

The viewer uses the `/cece/camera/image` Gazebo topic and needs Ubuntu Python
Tkinter and Pillow. Use the same `GZ_PARTITION` environment setting as the
Gazebo instance; for the current Windows session that is `cece_current`.
It shows simulated images, not a physical camera or the Wokwi ESP32.
