javadtaghia/cece-the-robot/experiments/cece/esp_head_carrier/R11_REVIEW.md

# Cece carrier R11: pin access

The marked upper cap is opened above the board channel with a 22.3 x 7.1 mm through-slot. Its length covers the 21.3 mm module length plus 0.5 mm at each end. The cut also removes flap-root material inside this opening, so a hidden roof does not remain across it. The flap stays connected to the front retaining lip.

R10 depth, component positions, USB-first access, solid wall supports and the continuous main crossbar are retained. Previous revisions are preserved.

## Validation

- One valid connected solid and closed STL.
- No carrier material remains inside the pin-slot volume.
- Existing sampled insertion and modeled head, USB and ultrasonic clearance checks pass.
- Intentional wall-contact interference and camera housing preload remain unchanged.

The opening follows the screenshot; pin location, projection direction, protrusion and connector size are not measured or modeled. The checks do not prove actual pin-to-head clearance. Opening the cap reduces upper retention; inspect seating and retention with the real board.

Open Cece_Head_ESP_Assembly_R11.FCStd; print geometry is Cece_ESP_Side_Carrier_R11_PREVIEW.stl. R11 has not been sliced or printed.
