javadtaghia/cece-the-robot/experiments/cece2/cece2_forward_50hz_offsets.csv

time_s | left_hip_offset_deg | left_ankle_offset_deg | right_hip_offset_deg | right_ankle_offset_deg
0.0 | 0 | 0.0 | 0 | 0.0
0.02 | 0 | 0.6647 | 0 | 1.7712
0.04 | 0 | 2.379 | 0 | 6.355
0.06 | 0 | 4.723 | 0 | 12.7523
0.08 | 0 | 7.277 | 0 | 19.9633
0.1 | 0 | 9.621 | 0 | 26.8676
0.12 | 0 | 11.3353 | 0 | 32.1704
0.14 | 0 | 12.0 | 0 | 34.248
0.16 | 0 | 12.0 | 0 | 28.48
0.18 | 0 | 12.0 | 0 | 17.768
0.2 | 0.0 | 12.0 | 0.0 | 12.0
0.22 | 0.42 | 12.0 | 0.42 | 12.0
0.24 | 1.56 | 12.0 | 1.56 | 12.0
0.26 | 3.24 | 12.0 | 3.24 | 12.0
0.28 | 5.28 | 12.0 | 5.28 | 12.0
0.3 | 7.5 | 12.0 | 7.5 | 12.0
0.32 | 9.72 | 12.0 | 9.72 | 12.0
0.34 | 11.76 | 12.0 | 11.76 | 12.0
0.36 | 13.44 | 12.0 | 13.44 | 12.0
0.38 | 14.58 | 12.0 | 14.58 | 12.0
0.4 | 15.0 | 12.0 | 15.0 | 12.0
0.42 | 15.0 | 12.0 | 15.0 | 17.768
0.44 | 15.0 | 12.0 | 15.0 | 28.48
0.46 | 15.0 | 12.0 | 15.0 | 34.248
0.48 | 15.0 | 10.752 | 15.0 | 30.3474
0.5 | 15.0 | 7.776 | 15.0 | 21.3946
0.52 | 15.0 | 4.224 | 15.0 | 11.3655
0.54 | 15.0 | 1.248 | 15.0 | 3.3253
0.56 | 15.0 | -0.0 | 15.0 | -0.0
0.58 | 15.0 | -1.7712 | 15.0 | -0.6647
0.6 | 15.0 | -6.355 | 15.0 | -2.379
0.62 | 15.0 | -12.7523 | 15.0 | -4.723
0.64 | 15.0 | -19.9633 | 15.0 | -7.277
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
