javadtaghia/cece-the-robot/experiments/cece2/Cece2_FreeCAD_Front.png

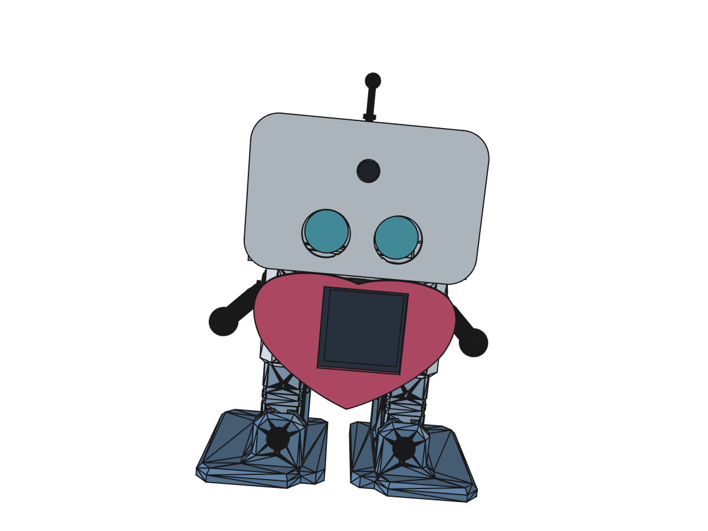
experiments/cece2/Cece2_FreeCAD_Front.png
