javadtaghia/cece-the-robot/experiments/cece2/Cece2_Gazebo_View.png

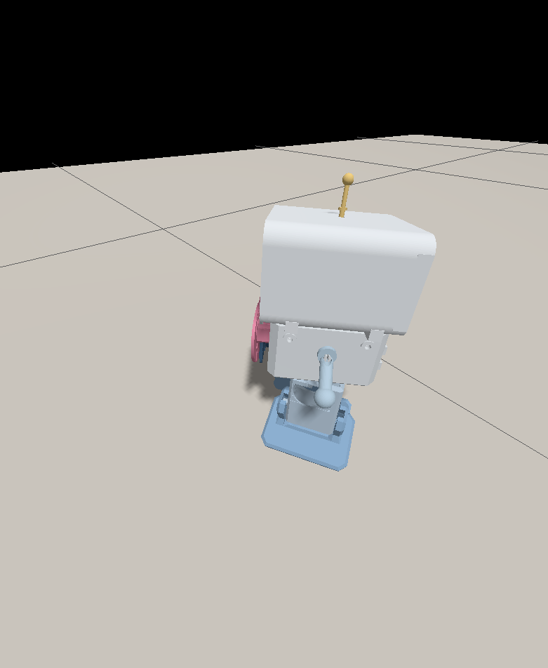
experiments/cece2/Cece2_Gazebo_View.png
