javadtaghia/cece-the-robot/experiments/cece/esp_head_carrier/Cece_Board_Clearance_R12.png

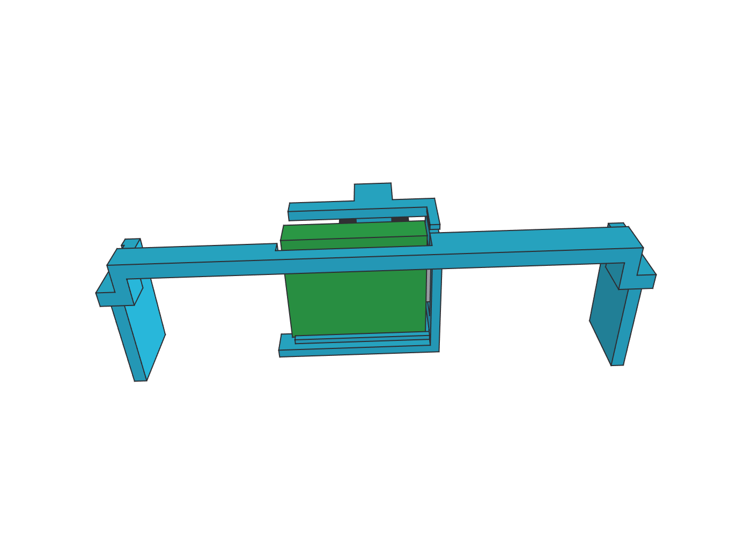
experiments/cece/esp_head_carrier/Cece_Board_Clearance_R12.png
