javadtaghia/cece-the-robot/experiments/cece/esp_head_carrier/Cece_Carrier_R9_Only.png

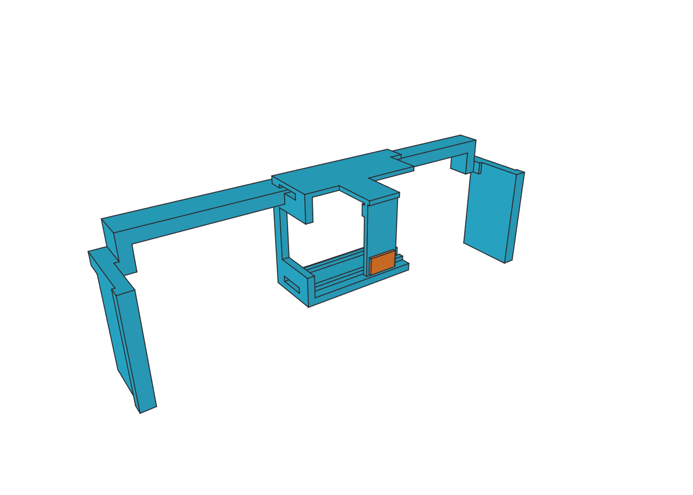
experiments/cece/esp_head_carrier/Cece_Carrier_R9_Only.png
