javadtaghia/cece-the-robot/experiments/cece/esp_head_carrier/Cece_Slide_Holder_R5_Detail.png

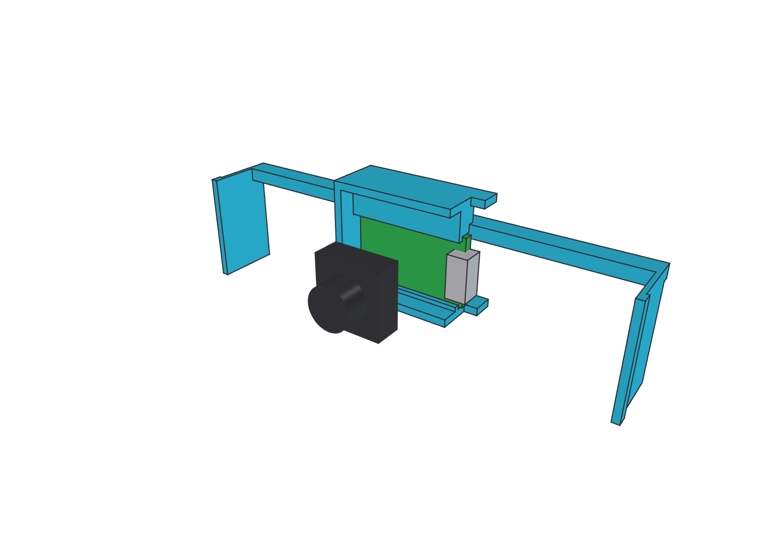
experiments/cece/esp_head_carrier/Cece_Slide_Holder_R5_Detail.png
