javadtaghia/cece-the-robot/experiments/cece/esp_head_carrier/Cece_Slide_Holder_R13_Detail.png

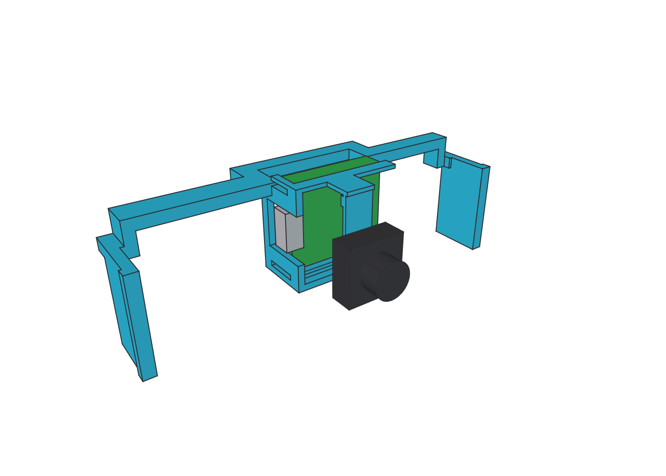
experiments/cece/esp_head_carrier/Cece_Slide_Holder_R13_Detail.png
