javadtaghia/cece-the-robot/experiments/cece/esp_head_carrier/Cece_U_Route_R13_Top.png

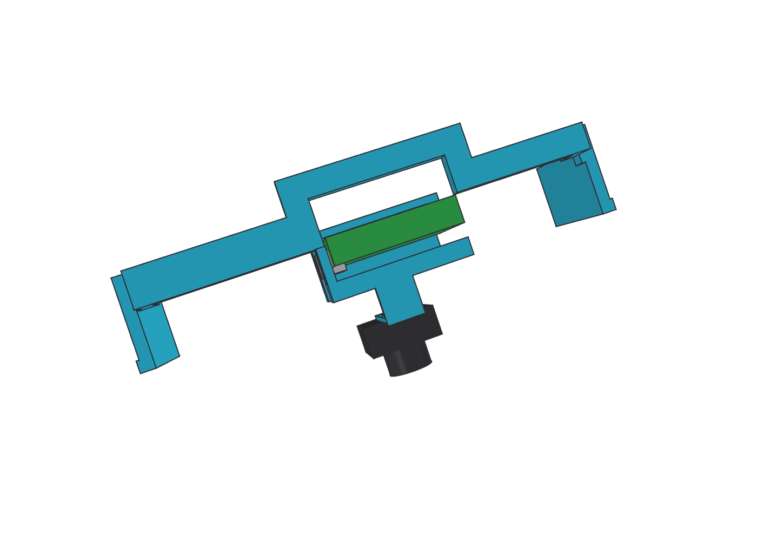
experiments/cece/esp_head_carrier/Cece_U_Route_R13_Top.png
