javadtaghia/cece-the-robot/experiments/cece/esp_head_carrier/Cradle_TEST_FIT_preview.png

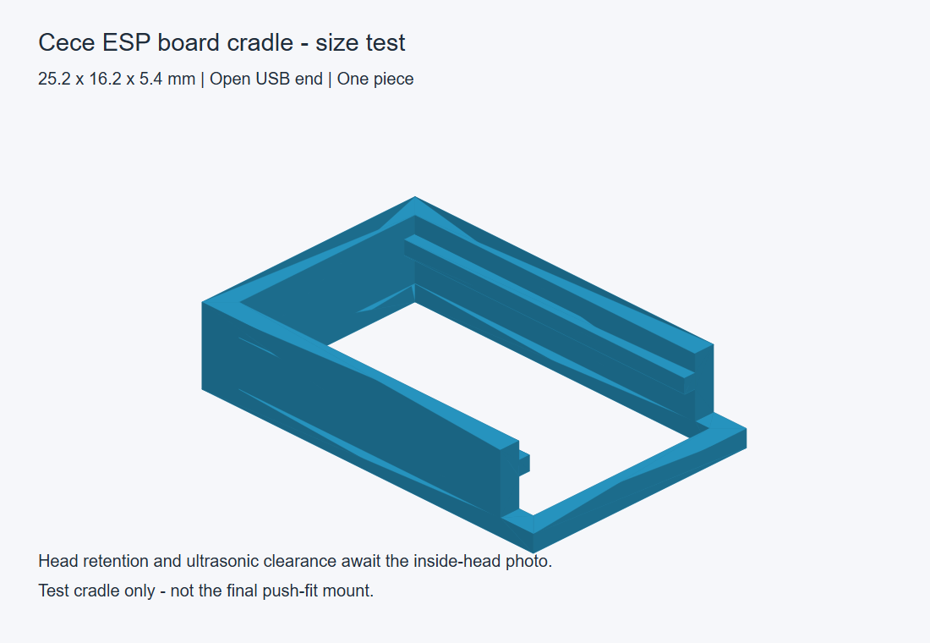
experiments/cece/esp_head_carrier/Cradle_TEST_FIT_preview.png
