javadtaghia/cece-the-robot/archive/workspace/Otto_PCB_Prototype/Otto_C3_SCHEMATIC_DRAFT.pdf

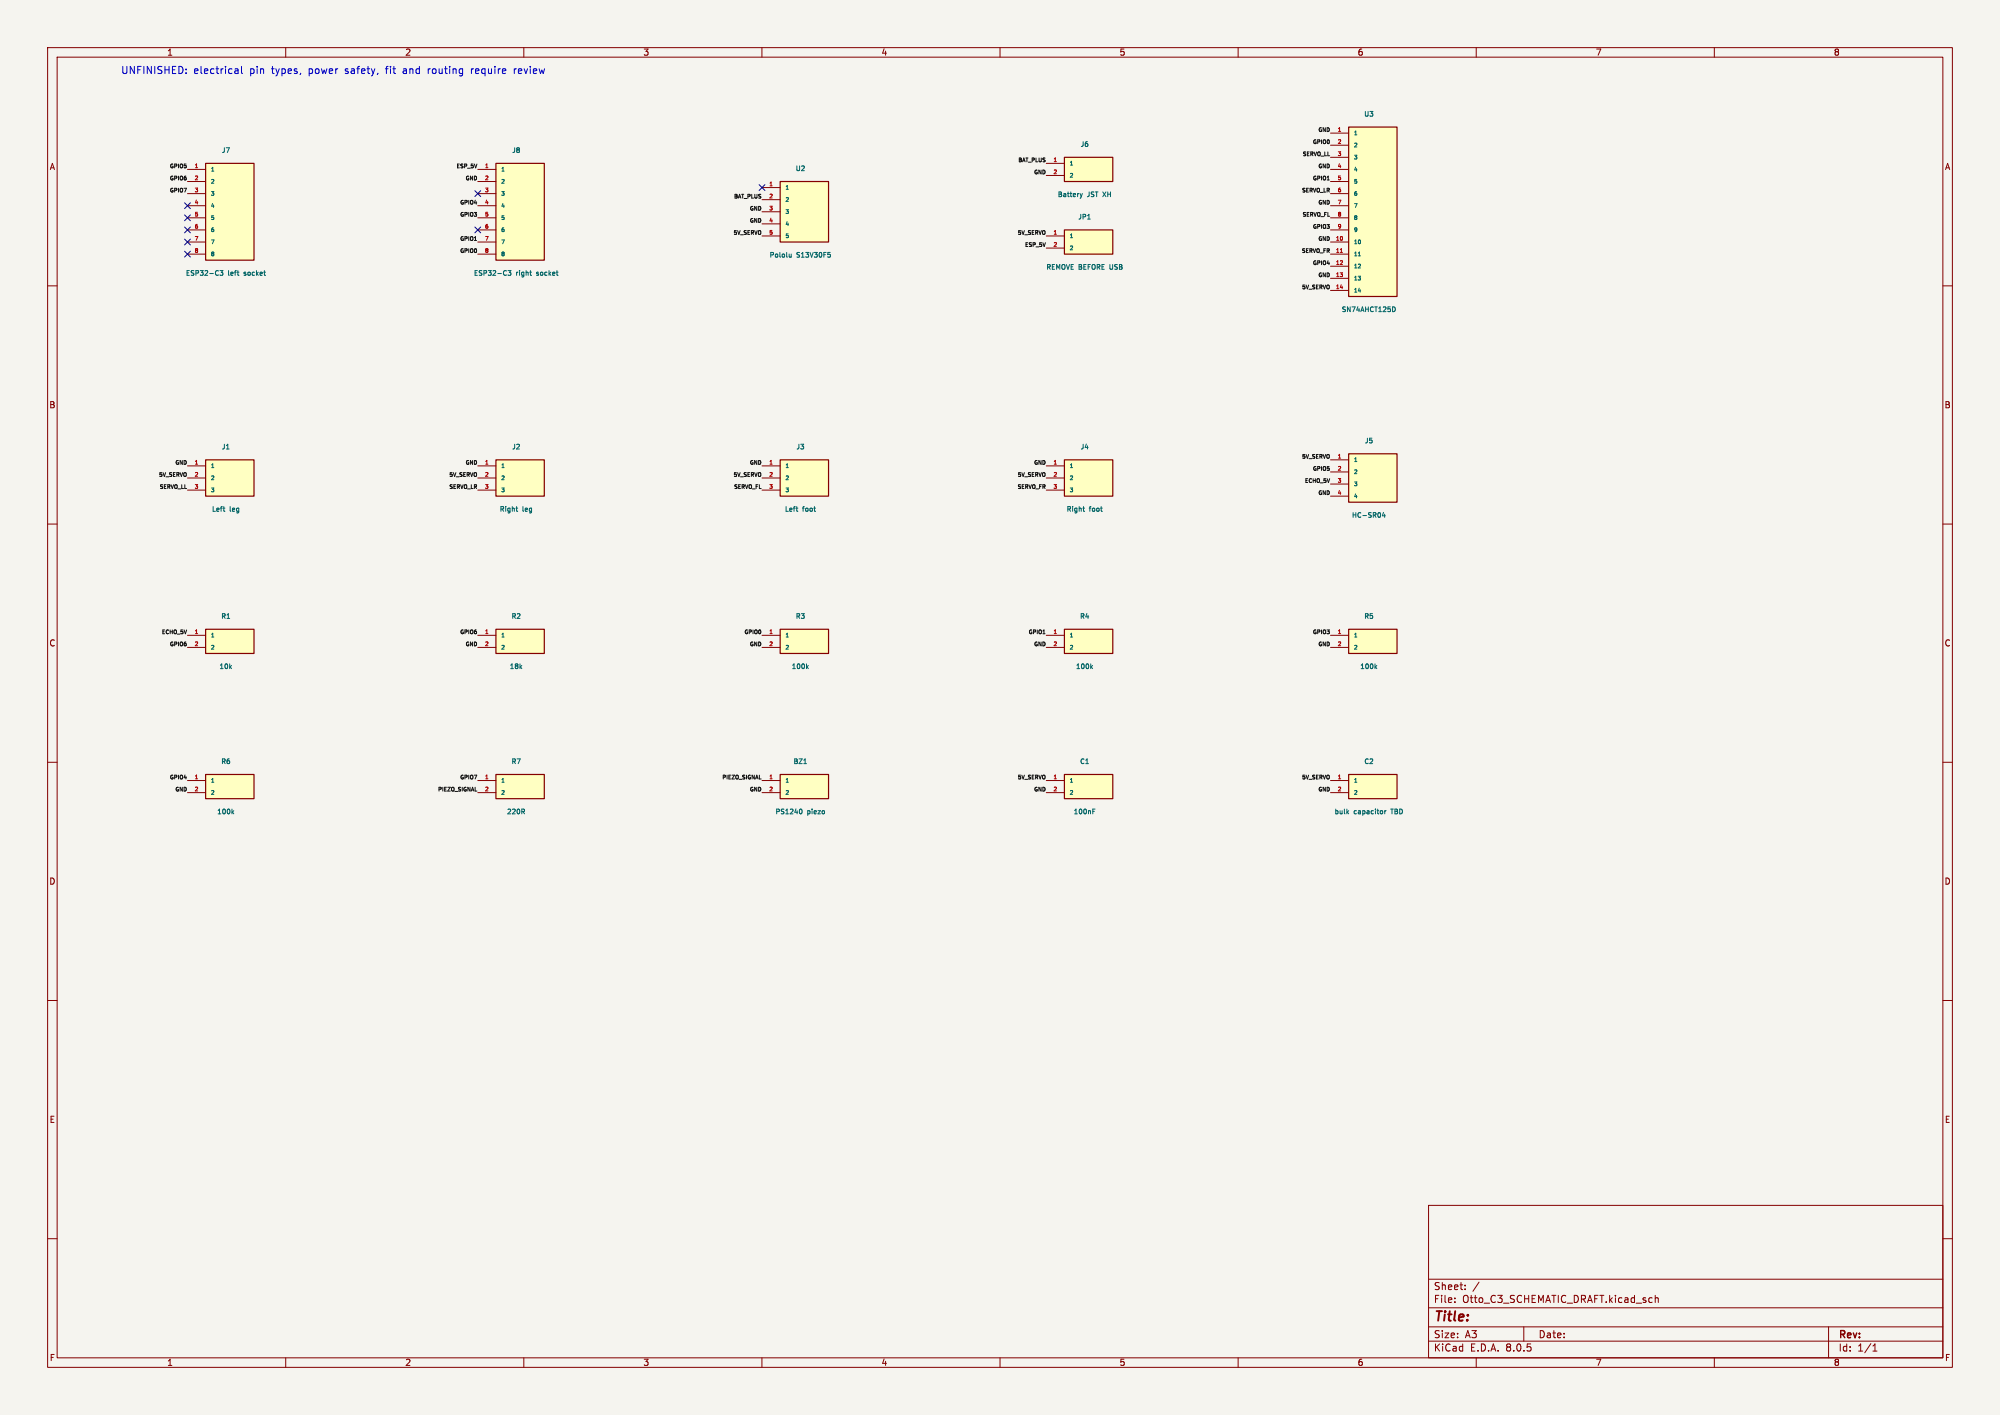
[picture p56: page 1]

Id: 1/1 Title: File: Otto_C3_SCHEMATIC_DRAFT.kicad_sch Sheet: /
