javadtaghia/cece-the-robot/archive/workspace/piicodev_servo_ref/Documents/piicodev-servo-driver-schematic.pdf

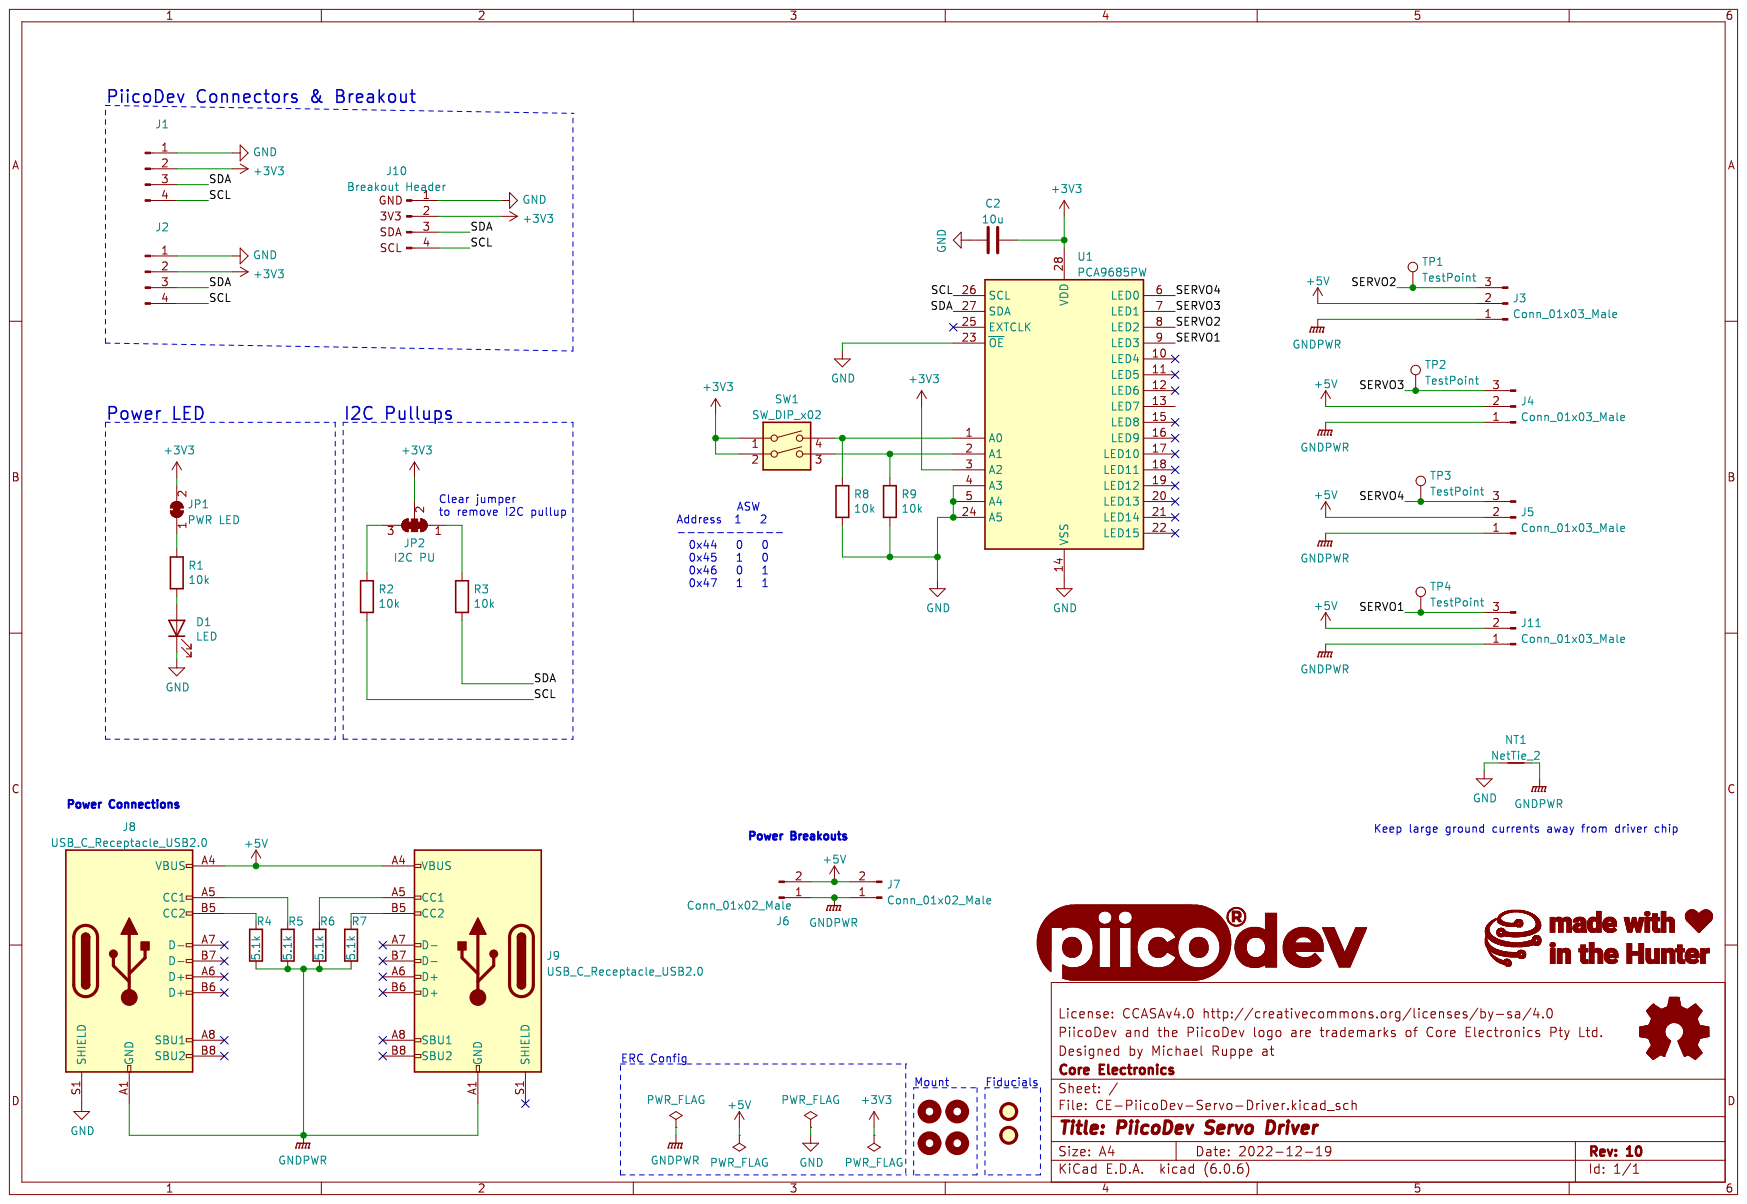
[picture p57: page 1]
