javadtaghia/cece-the-robot/(list of files, drawings)

Other design files:
archive/workspace/Otto_PCB_Prototype/otto_c3_wide_trial.dsn
archive/workspace/Otto_PCB_Prototype/otto_c3_working.dsn
