javadtaghia/cece-the-robot/experiments/cece/electronics/kicad_s3_bench/Cece_USB_Bench_Wiring.kicad_sch

## KiCad design experiments/cece/electronics/kicad_s3_bench/Cece_USB_Bench_Wiring.kicad_sch (2026-11-14)

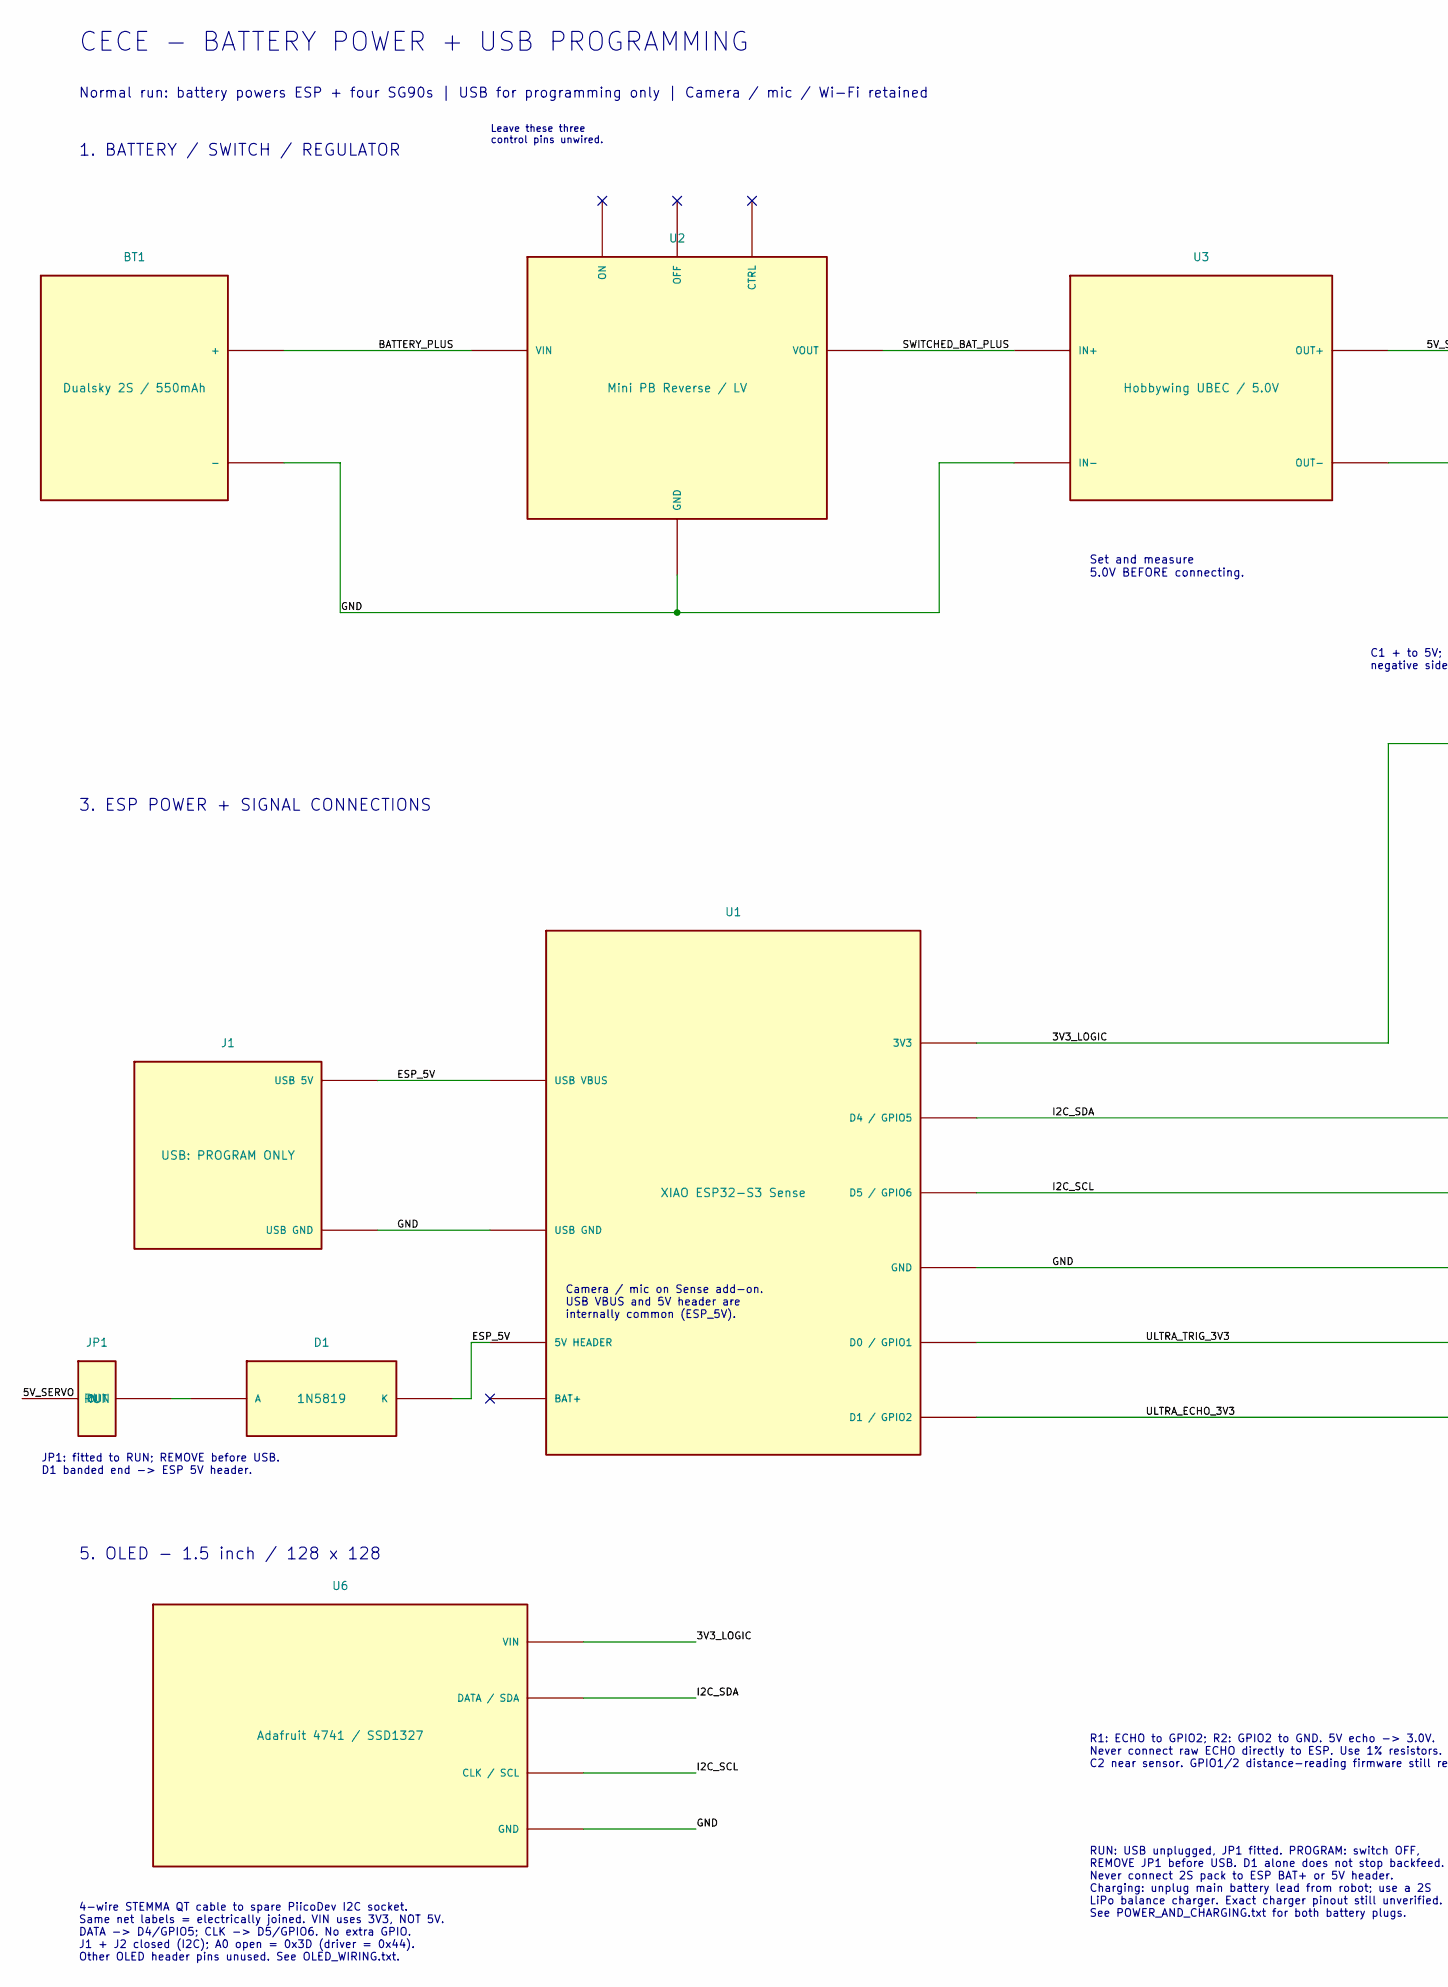
[picture p58: schematic Cece_USB_Bench_Wiring.kicad_sch, part in row 1, column 1]

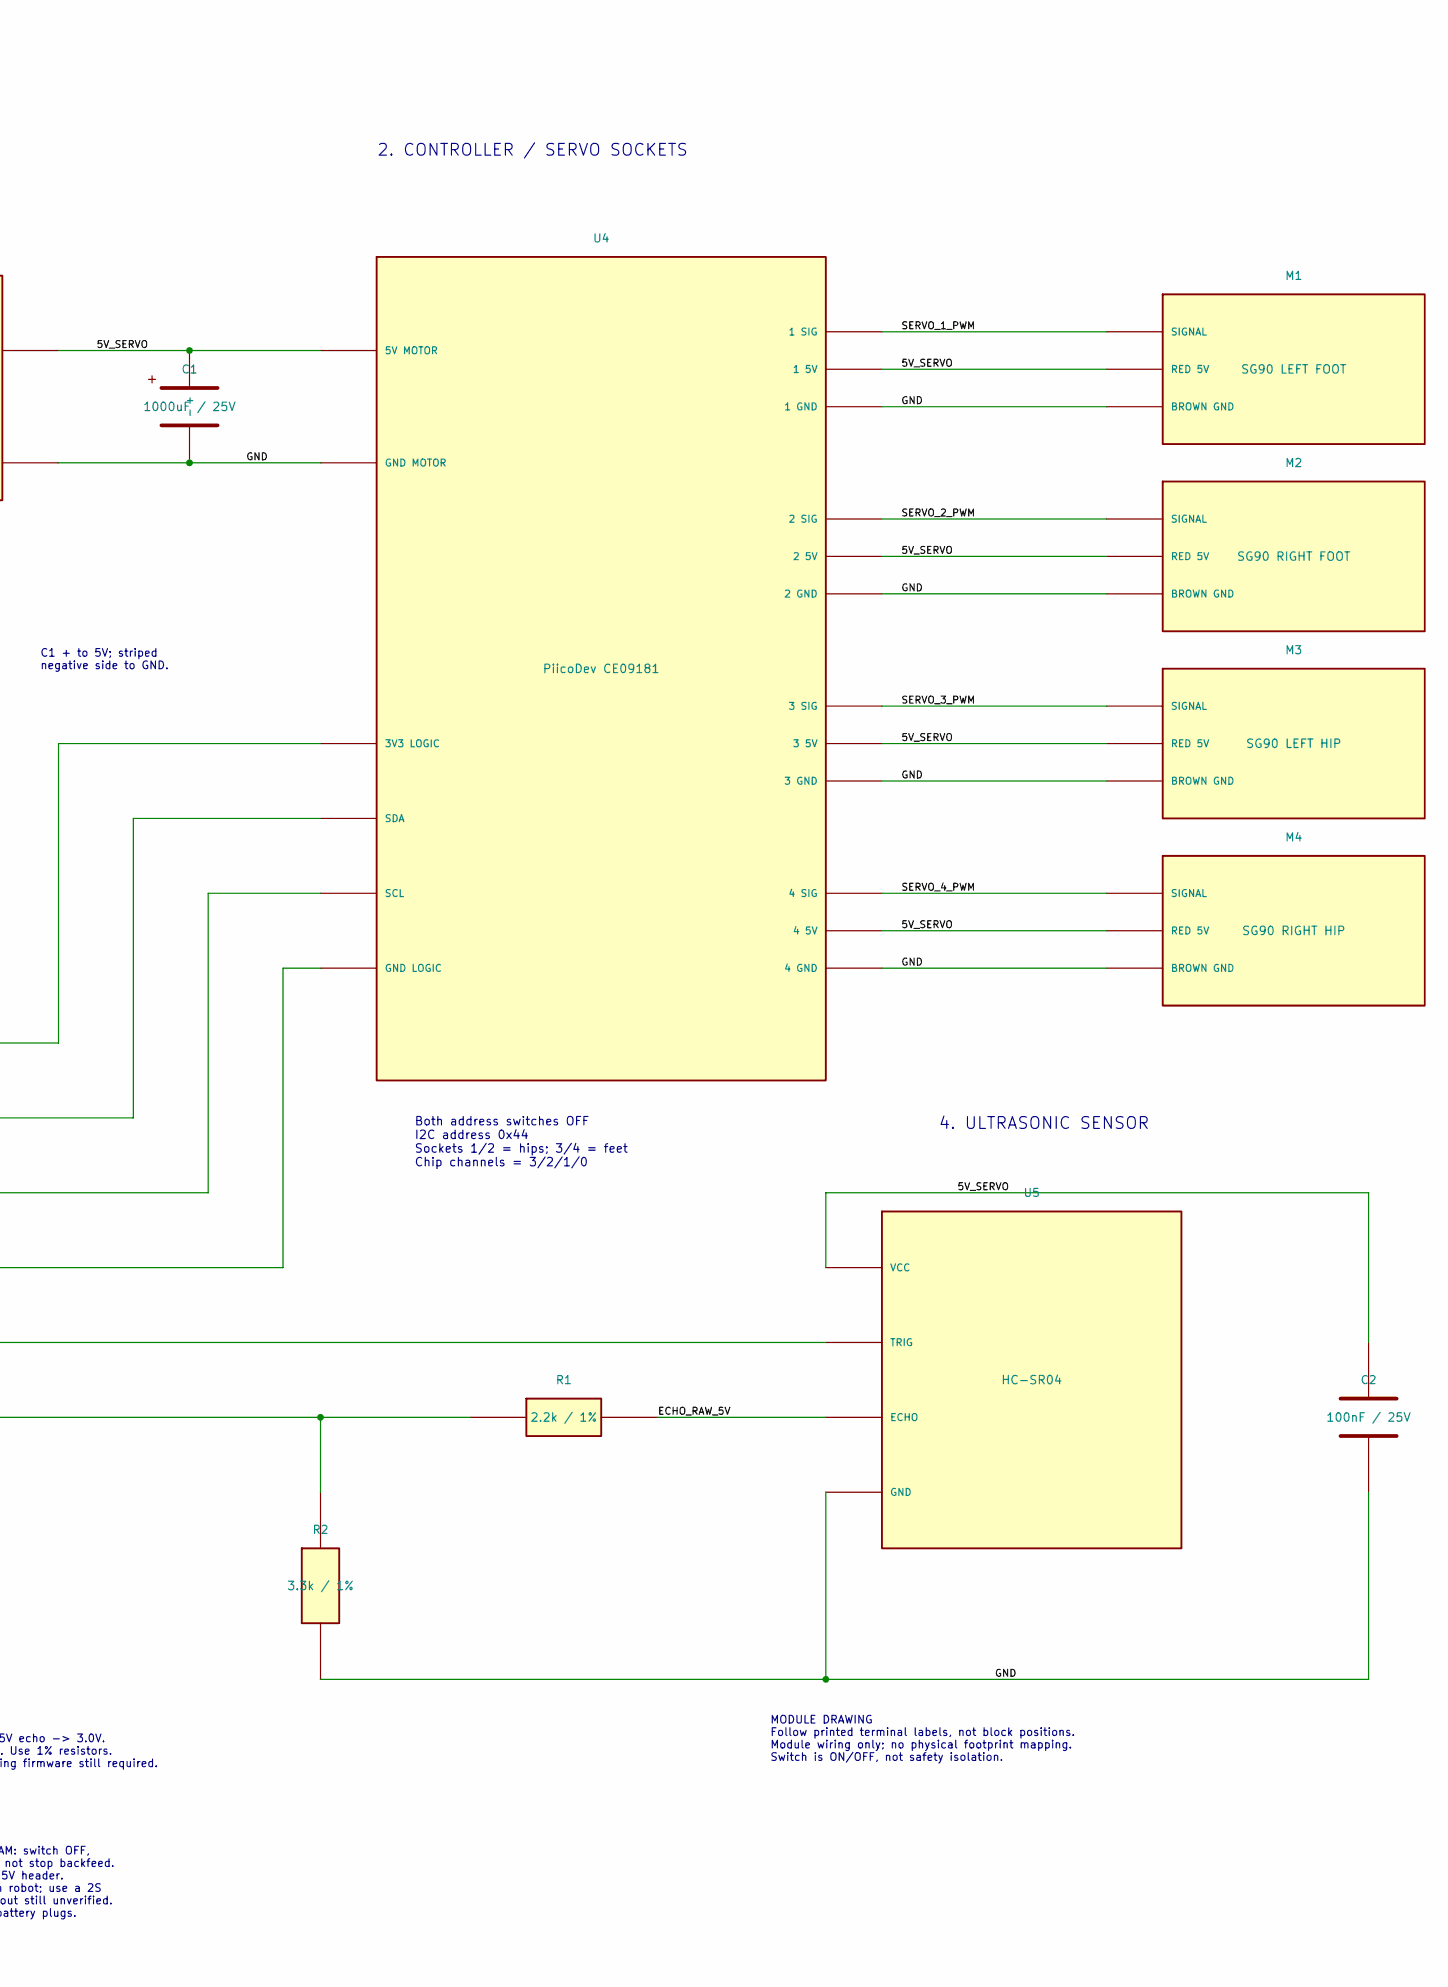
[picture p59: schematic Cece_USB_Bench_Wiring.kicad_sch, part in row 1, column 2]

Parts:
BT1: Dualsky 2S / 550mAh
C1: 1000uF / 25V
C2: 100nF / 25V
D1: 1N5819
J1: USB: PROGRAM ONLY
JP1: RUN
M1: SG90 LEFT FOOT
M2: SG90 RIGHT FOOT
M3: SG90 LEFT HIP
M4: SG90 RIGHT HIP
R1: 2.2k / 1%
R2: 3.3k / 1%
U1: XIAO ESP32-S3 Sense
U2: Mini PB Reverse / LV
U3: Hobbywing UBEC / 5.0V
U4: PiicoDev CE09181
U5: HC-SR04
U6: Adafruit 4741 / SSD1327

Connections:
3V3_LOGIC: U1.3V3, U4.3V3 LOGIC, U6.VIN
5V_SERVO: C1.+, C2.1, JP1.IN, M1.RED 5V, M2.RED 5V, M3.RED 5V, M4.RED 5V, U3.OUT+, U4.1 5V, U4.2 5V, U4.3 5V, U4.4 5V, U4.5V MOTOR, U5.VCC
BATTERY_PLUS: BT1.+, U2.VIN
ECHO_RAW_5V: R1.2, U5.ECHO
ESP_5V: D1.K, J1.USB 5V, U1.5V HEADER, U1.USB VBUS
GND: BT1.-, C1.-, C2.2, J1.USB GND, M1.BROWN GND, M2.BROWN GND, M3.BROWN GND, M4.BROWN GND, R2.2, U1.GND, U1.USB GND, U2.GND, U3.IN-, U3.OUT-, U4.1 GND, U4.2 GND, U4.3 GND, U4.4 GND, U4.GND LOGIC, U4.GND MOTOR, U5.GND, U6.GND
I2C_SCL: U1.D5 / GPIO6, U4.SCL, U6.CLK / SCL
I2C_SDA: U1.D4 / GPIO5, U4.SDA, U6.DATA / SDA
unnamed: D1.A, JP1.OUT
SERVO_1_PWM: M1.SIGNAL, U4.1 SIG
SERVO_2_PWM: M2.SIGNAL, U4.2 SIG
SERVO_3_PWM: M3.SIGNAL, U4.3 SIG
SERVO_4_PWM: M4.SIGNAL, U4.4 SIG
SWITCHED_BAT_PLUS: U2.VOUT, U3.IN+
ULTRA_ECHO_3V3: R1.1, R2.1, U1.D1 / GPIO2
ULTRA_TRIG_3V3: U1.D0 / GPIO1, U5.TRIG

Notes on the sheet:
4. ULTRASONIC SENSOR
R1: ECHO to GPIO2; R2: GPIO2 to GND. 5V echo -> 3.0V. Never connect raw ECHO directly to ESP. Use 1% resistors. C2 near sensor. GPIO1/2 distance-reading firmware still required.
CECE - BATTERY POWER + USB PROGRAMMING
Normal run: battery powers ESP + four SG90s | USB for programming only | Camera / mic / Wi-Fi retained
1. BATTERY / SWITCH / REGULATOR
2. CONTROLLER / SERVO SOCKETS
Leave these three control pins unwired.
Set and measure 5.0V BEFORE connecting.
C1 + to 5V; striped negative side to GND.
3. ESP POWER + SIGNAL CONNECTIONS
Camera / mic on Sense add-on. USB VBUS and 5V header are internally common (ESP_5V).
JP1: fitted to RUN; REMOVE before USB. D1 banded end -> ESP 5V header.
Both address switches OFF I2C address 0x44 Sockets 1/2 = hips; 3/4 = feet Chip channels = 3/2/1/0
5. OLED - 1.5 inch / 128 x 128
4-wire STEMMA QT cable to spare PiicoDev I2C socket. Same net labels = electrically joined. VIN uses 3V3, NOT 5V. DATA -> D4/GPIO5; CLK -> D5/GPIO6. No extra GPIO. J1 + J2 closed (I2C); A0 open = 0x3D (driver = 0x44). Other OLED header pins unused. See OLED_WIRING.txt.
RUN: USB unplugged, JP1 fitted. PROGRAM: switch OFF, REMOVE JP1 before USB. D1 alone does not stop backfeed. Never connect 2S pack to ESP BAT+ or 5V header. Charging: unplug main battery lead from robot; use a 2S LiPo balance charger. Exact charger pinout still unverified. See POWER_AND_CHARGING.tx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
MODULE DRAWING Follow printed terminal labels, not block positions. Module wiring only; no physical footprint mapping. Switch is ON/OFF, not safety isolation.
