javadtaghia/cece-the-robot/experiments/cece/electronics/kicad_s3_bench/Cece_Ultrasonic.kicad_sch

## KiCad design experiments/cece/electronics/kicad_s3_bench/Cece_Ultrasonic.kicad_sch (2026-11-09)

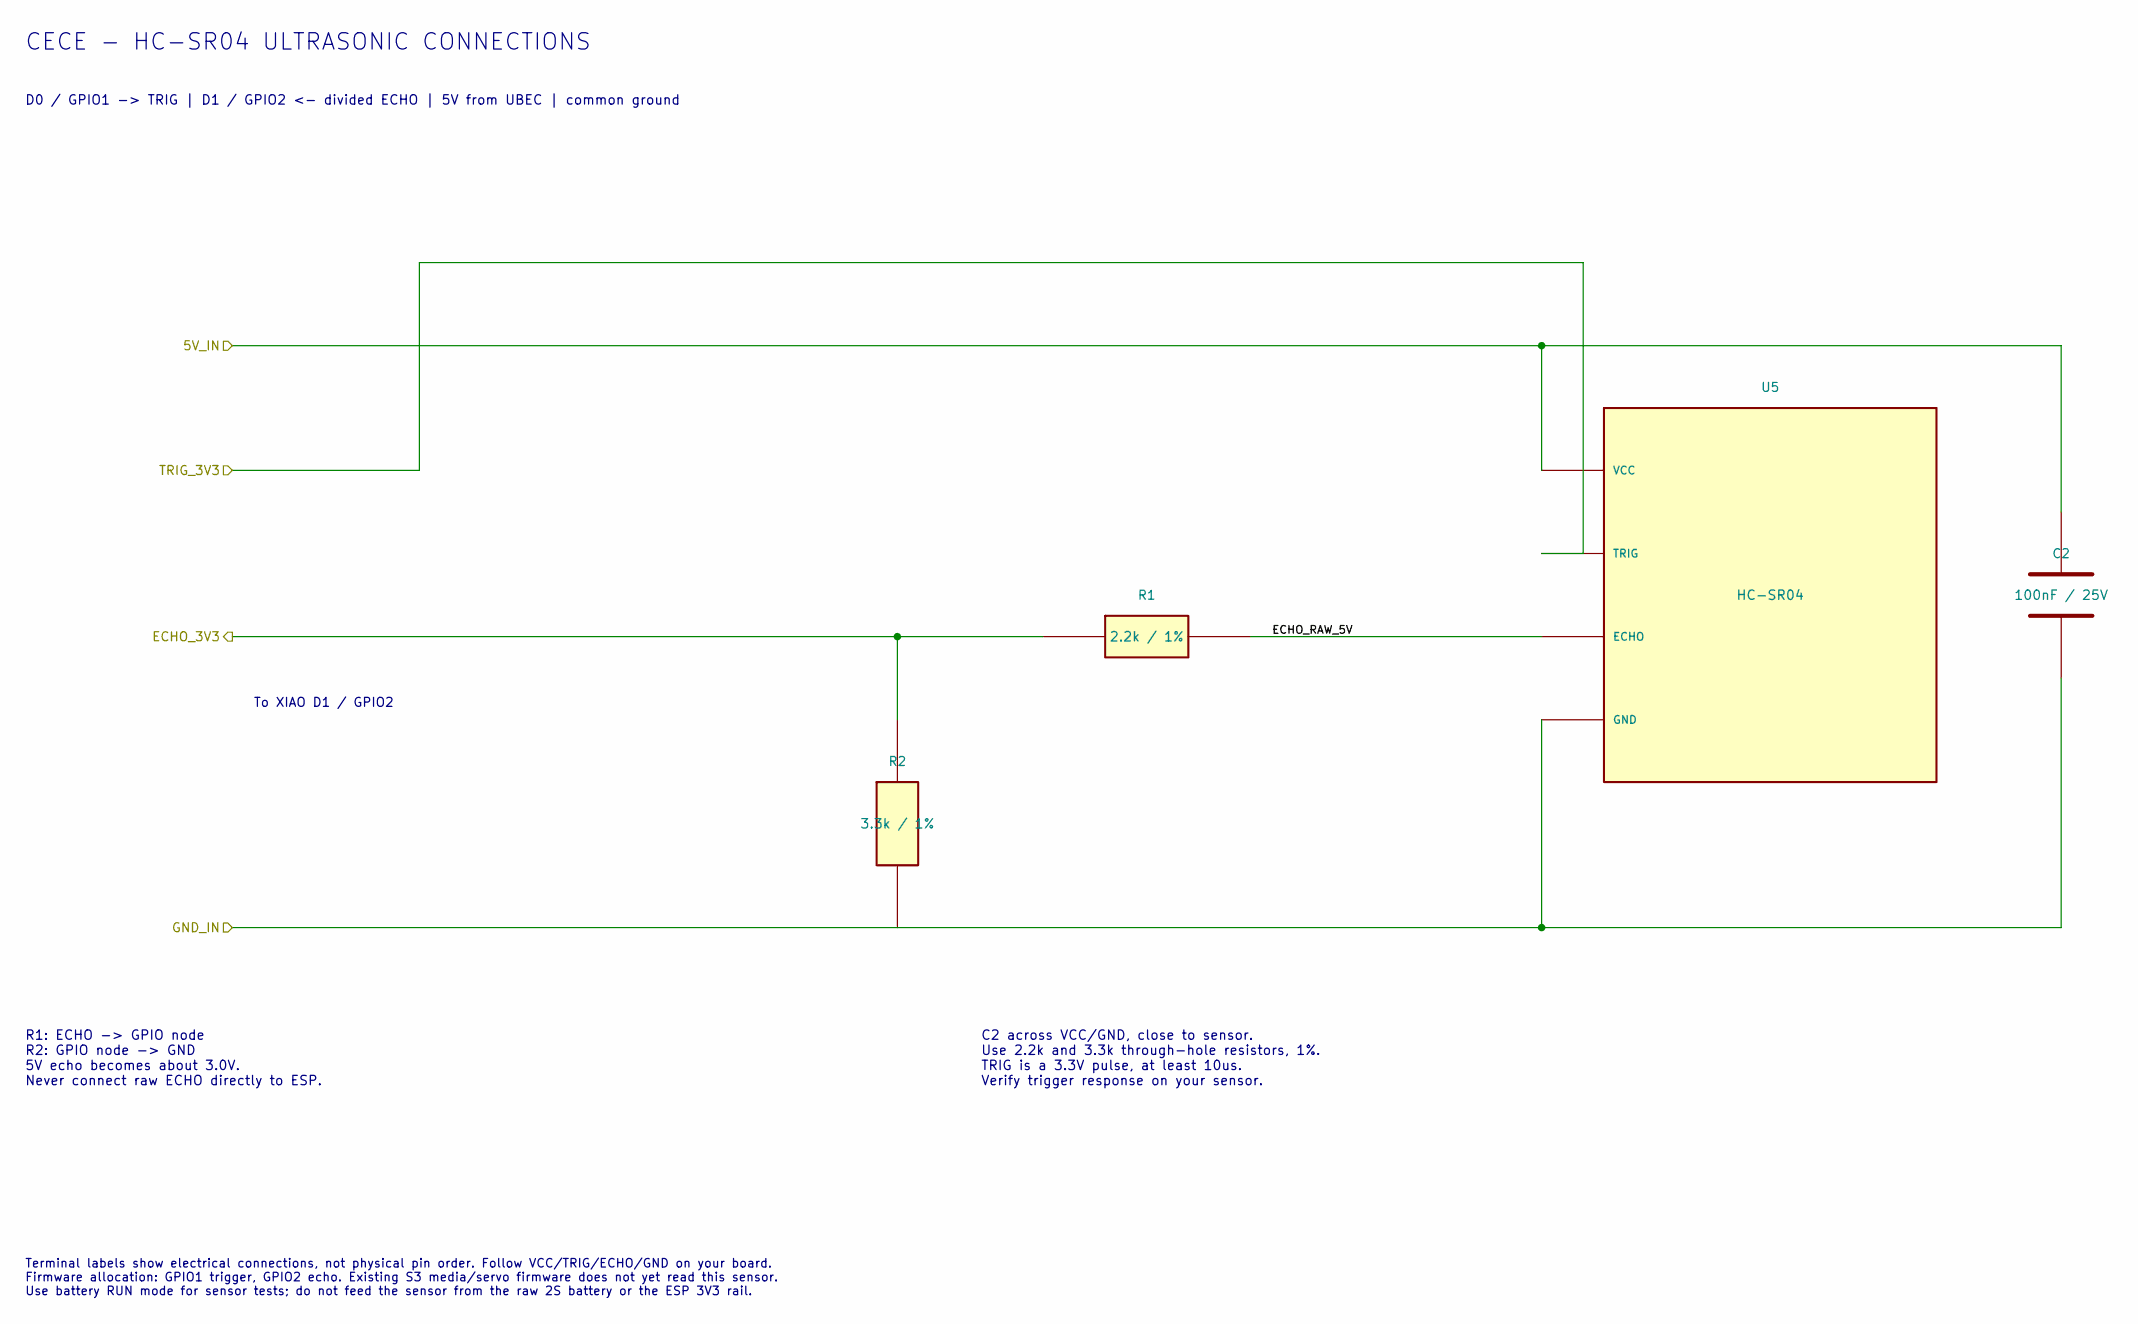
[picture p60: schematic Cece_Ultrasonic.kicad_sch]

Parts:
C2: 100nF / 25V
R1: 2.2k / 1%
R2: 3.3k / 1%
U5: HC-SR04

Connections:
5V_IN: C2.1, U5.VCC
ECHO_3V3: R1.1, R2.1
ECHO_RAW_5V: R1.2, U5.ECHO
GND_IN: C2.2, R2.2, U5.GND
TRIG_3V3: U5.TRIG

Notes on the sheet:
CECE - HC-SR04 ULTRASONIC CONNECTIONS
D0 / GPIO1 -> TRIG | D1 / GPIO2 <- divided ECHO | 5V from UBEC | common ground
To XIAO D1 / GPIO2
R1: ECHO -> GPIO node R2: GPIO node -> GND 5V echo becomes about 3.0V. Never connect raw ECHO directly to ESP.
C2 across VCC/GND, close to sensor. Use 2.2k and 3.3k through-hole resistors, 1%. TRIG is a 3.3V pulse, at least 10us. Verify trigger response on your sensor.
Terminal labels show electrical connections, not physical pin order. Follow VCC/TRIG/ECHO/GND on your board. Firmware allocation: GPIO1 trigger, GPIO2 echo. Existing S3 media/servo firmware does not yet read this sensor. Use battery RUN mode for sensor tests; do not feed the sensor from the raw 2S 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
