javadtaghia/cece-the-robot/experiments/bench_tests/arduino_due_sg90/DueServo4Continuous/Cece2Servo4Gait.h

// GENERATED from experiments/cece2/gait.py, joint index 3 (right ankle).
// Signed hundredths of a nominal degree relative to neutral.
#pragma once
#include <stdint.h>
const uint16_t GAIT_SAMPLE_MS = 20;
const uint16_t GAIT_SAMPLE_COUNT = 56;
const int16_t SERVO4_GAIT_CDEG[GAIT_SAMPLE_COUNT] = {
  0, 177, 635, 1275, 1996, 2687, 3217, 3425,
  2848, 1777, 1200, 1200, 1200, 1200, 1200, 1200,
  1200, 1200, 1200, 1200, 1200, 1777, 2848, 3425,
  3035, 2139, 1137, 333, 0, -66, -238, -472,
  -728, -962, -1134, -1200, -1200, -1200, -1200, -1200,
  -1200, -1200, -1200, -1200, -1200, -1200, -1200, -1200,
  -1200, -1200, -1200, -1200, -1075, -778, -422, -125,
};
