javadtaghia/cece-the-robot/experiments/cece/firmware/CeceBench/pc_bridge/laptop_voice.py

"""Push-to-talk laptop audio for the Wokwi Cece bench, not physical I2S."""
import argparse
from array import array
import base64
import os
import tempfile
import wave
import winsound
import audioop
import json
import queue
import subprocess
import threading
import time
import urllib.request
import urllib.parse
import tkinter as tk
from tkinter import ttk

import serial
import sounddevice as sd
from vosk import KaldiRecognizer, Model, SetLogLevel

def record(model, device, seconds, whisper=False, device_name=None, stop_event=None):
    # Refresh PortAudio's inventory: Windows can renumber devices while the
    # application is open, for example when switching remote audio sessions.
    if device_name:
        sd._terminate()
        sd._initialize()
        for index, candidate in enumerate(sd.query_devices()):
            label = (candidate["name"].replace("\r", " ").replace("\n", " ") +
                     " (" + sd.query_hostapis(candidate["hostapi"])["name"] + ")")
            if candidate["max_input_channels"] > 0 and label == device_name:
                device = index
                break
        else:
            raise RuntimeError("The selected microphone is no longer available; reopen Cece and select it again.")
    info = sd.query_devices(device, "input")
    rate = int(info["default_samplerate"])
    try:
        sd.check_input_settings(device=device, channels=1, samplerate=rate, dtype="int16")
        channels = 1
    except sd.PortAudioError:
        channels = int(info["max_input_channels"])
    frames = queue.Queue()
    def callback(indata, frame_count, timing, status):
        frames.put(bytes(indata))
    recognizer = None if whisper else KaldiRecognizer(model, 16000)
    state = None
    segments = []
    audio_chunks = []
    peak = 0
    speech_started = False
    last_voice = None
    with sd.RawInputStream(samplerate=rate, blocksize=4000, dtype="int16",
                           channels=channels, device=device, callback=callback):
        deadline = time.monotonic() + seconds if seconds else None
        while (deadline is None or time.monotonic() < deadline) and not (stop_event and stop_event.is_set()):
            try:
                block = frames.get(timeout=0.5)
            except queue.Empty:
                continue
            if channels > 1:
                raw = array("h")
                raw.frombytes(block)
                candidates = [raw[i::channels] for i in range(channels)]
                chosen = max(candidates, key=lambda ch: max(map(abs, ch), default=0))
                block = chosen.tobytes()
            peak = max(peak, audioop.max(block, 2))
            block_peak = audioop.max(block, 2)
            now = time.monotonic()
            if block_peak >= 300:
                speech_started = True
                last_voice = now
            elif speech_started and last_voice is not None and now - last_voice >= 1.2:
                break
            if block_peak:
                block = audioop.mul(block, 2, min(8.0, max(1.0, 6000.0 / block_peak)))
            if rate != 16000:
                block, state = audioop.ratecv(block, 2, 1, rate, 16000, state)
            if whisper:
                if speech_started:
                    audio_chunks.append(block)
            elif recognizer.AcceptWaveform(block):
                segments.append(json.loads(recognizer.Result()).get("text", ""))
    if stop_event and stop_event.is_set():
        return "", peak
    if not speech_started:
        return "", peak
    if whisper:
        import numpy as np
        audio = np.frombuffer(b"".join(audio_chunks), dtype="<i2").astype(np.float32) / 32768
        parts, _ = model.transcribe(audio, language="en", beam_size=5, vad_filter=False,
                                    condition_on_previous_text=False)
        return " ".join(part.text.strip() for part in parts).strip(), peak
    segments.append(json.loads(recognizer.FinalResult()).get("text", ""))
    return " ".join(x for x in segments if x).strip(), peak

def record_robot(model, base_url, token, whisper=False, stop_event=None):
    """Read 16 kHz mono I2S chunks from the experimental physical ESP32 endpoint."""
    url = urllib.parse.urlsplit(base_url.strip())
    if url.scheme != "http" or not url.hostname or url.username or url.password or url.path not in ("", "/") or url.query or url.fragment:
        raise ValueError("Enter the robot's LAN URL")
    if not 16 <= len(token) <= 64 or any(c.isspace() for c in token):
        raise ValueError("Enter the robot's 16-64 character token")
    recognizer = None if whisper else KaldiRecognizer(model, 16000)
    chunks, segments = [], []
    last_voice, peak = None, 0
    while not (stop_event and stop_event.is_set()):
        request = urllib.request.Request(base_url.rstrip("/") + "/microphone",
            headers={"X-Cece-Token": token})
        with urllib.request.urlopen(request, timeout=8) as response:
            block = response.read(8193)
        if len(block) != 8192:
            raise RuntimeError("Robot microphone returned an incomplete audio block")
        block_peak = audioop.max(block, 2)
        peak = max(peak, block_peak)
        now = time.monotonic()
        if block_peak >= 300:
            last_voice = now
        elif last_voice is not None and now - last_voice >= 1.2:
            break
        if block_peak:
            block = audioop.mul(block, 2, min(8.0, max(1.0, 6000.0 / block_peak)))
        if whisper:
            if last_voice is not None:
                chunks.append(block)
        elif recognizer.AcceptWaveform(block):
            segments.append(json.loads(recognizer.Result()).get("text", ""))
    if stop_event and stop_event.is_set() or last_voice is None:
        return "", peak
    if whisper:
        import numpy as np
        audio = np.frombuffer(b"".join(chunks), dtype="<i2").astype(np.float32) / 32768
        parts, _ = model.transcribe(audio, language="en", beam_size=5, vad_filter=False,
                                    condition_on_previous_text=False)
        return " ".join(part.text.strip() for part in parts).strip(), peak
    segments.append(json.loads(recognizer.FinalResult()).get("text", ""))
    return " ".join(x for x in segments if x).strip(), peak

def ask_esp(text):
    # The existing C3 serial parser accepts at most 96 chars per line.
    safe = " ".join(text.split())[:43]
    if not safe:
        raise ValueError("No speech was recognized.")
    with serial.serial_for_url("rfc2217://127.0.0.1:4000",
                               baudrate=115200, timeout=1) as port:
        time.sleep(0.5)
        port.reset_input_buffer()
        port.write(b"wifi Wokwi-GUEST -\n")
        deadline = time.monotonic() + 30
        connected = False
        while time.monotonic() < deadline:
            port.write(b"status\n")
            until = time.monotonic() + 2
            while time.monotonic() < until:
                line = port.readline().decode("utf-8", "replace").strip()
                if line.startswith("WiFi connected IP:"):
                    connected = True
                    break
            if connected:
                break
        if not connected:
            raise RuntimeError("The simulated ESP32 could not connect to Wokwi Wi-Fi.")
        port.write(("ask http://host.wokwi.internal:8768/ask " + safe + "\n").encode())
        deadline = time.monotonic() + 80
        while time.monotonic() < deadline:
            line = port.readline().decode("utf-8", "replace").strip()
            if line.startswith("LLM: "):
                return line[5:]
            if line.startswith(("Bridge request failed:", "Usage: connect WiFi")):
                raise RuntimeError(line)
        raise TimeoutError("No response from the simulated ESP32.")

def ask_local_bridge(text):
    payload = " ".join(text.split()).encode("utf-8")
    if not payload or len(payload) > 200:
        raise ValueError("Message must be 1-200 UTF-8 bytes")
    request = urllib.request.Request("http://127.0.0.1:8768/ask", data=payload, method="POST",
        headers={"Content-Type": "text/plain; charset=utf-8"})
    with urllib.request.urlopen(request, timeout=80) as response:
        return response.read(1000).decode("utf-8", "replace")

def oled_excerpt(message):
    return message.encode("utf-8")[:120].decode("utf-8", "ignore")

def send_robot_message(base_url, token, message):
    """Send one OLED message to the ESP32's opt-in LAN endpoint."""
    url = urllib.parse.urlsplit(base_url.strip())
    if url.scheme != "http" or not url.hostname or url.username or url.password or url.path not in ("", "/") or url.query or url.fragment:
        raise ValueError("Use the robot's LAN URL, for example http://192.168.1.42")
    if not 16 <= len(token) <= 64 or any(c.isspace() for c in token):
        raise ValueError("Robot token must be 16-64 characters without spaces")
    payload = message.strip().encode("utf-8")
    if not payload or len(payload) > 120:
        raise ValueError("Message must be 1-120 UTF-8 bytes")
    request = urllib.request.Request(base_url.rstrip("/") + "/message", data=payload, method="POST",
        headers={"Content-Type": "text/plain; charset=utf-8", "X-Cece-Token": token})
    with urllib.request.urlopen(request, timeout=5) as response:
        return response.read(256).decode("utf-8", "replace")

def robot_request(base_url, token, path, payload=None, timeout=8):
    url = urllib.parse.urlsplit(base_url.strip())
    if url.scheme != "http" or not url.hostname or url.username or url.password or url.path not in ("", "/") or url.query or url.fragment:
        raise ValueError("Enter the robot's LAN URL")
    if not 16 <= len(token) <= 64 or any(c.isspace() for c in token):
        raise ValueError("Enter the robot's 16-64 character token")
    request = urllib.request.Request(base_url.rstrip("/") + path, data=payload,
        method="POST" if payload is not None else "GET", headers={"X-Cece-Token": token,
        "Content-Type": "text/plain; charset=utf-8"})
    with urllib.request.urlopen(request, timeout=timeout) as response:
        return response.read()

def speak_mirrored(text, base_url, token):
    """Generate one Windows voice clip, play locally and send PCM to the ESP32."""
    fd, path = tempfile.mkstemp(suffix=".wav", prefix="cece_speech_")
    os.close(fd)
    try:
        command = ("Add-Type -AssemblyName System.Speech; "
            "$s=New-Object System.Speech.Synthesis.SpeechSynthesizer; "
            "$f=New-Object System.Speech.AudioFormat.SpeechAudioFormatInfo(16000, "
            "[System.Speech.AudioFormat.AudioBitsPerSample]::Sixteen, "
            "[System.Speech.AudioFormat.AudioChannel]::Mono); "
            "$s.SetOutputToWaveFile($env:CECE_AUDIO_TEMP, $f); $s.Speak([Console]::In.ReadToEnd()); $s.Dispose()")
        subprocess.run(["powershell.exe", "-NoProfile", "-NonInteractive", "-Command", command],
            input=text, text=True, encoding="utf-8", check=True,
            env={**os.environ, "CECE_AUDIO_TEMP": path}, creationflags=subprocess.CREATE_NO_WINDOW)
        with wave.open(path, "rb") as wav:
            if (wav.getnchannels(), wav.getsampwidth(), wav.getframerate()) != (1, 2, 16000):
                raise ValueError("Unexpected synthesized audio format")
            duration = wav.getnframes() / wav.getframerate()
            started = time.monotonic()
            winsound.PlaySound(path, winsound.SND_FILENAME | winsound.SND_ASYNC)
            while True:
                pcm = wav.readframes(2048)
                if not pcm:
                    break
                robot_request(base_url, token, "/speaker", base64.b64encode(pcm))
        # Keep the file until local playback finishes; WinMM reads asynchronously.
        time.sleep(max(0.0, duration - (time.monotonic() - started)))
    finally:
        try:
            os.unlink(path)
        except OSError:
            pass

def speak(text):
    command = ("Add-Type -AssemblyName System.Speech; "
               "$s=New-Object System.Speech.Synthesis.SpeechSynthesizer; "
               "$s.Speak([Console]::In.ReadToEnd())")
    subprocess.run(["powershell.exe", "-NoProfile", "-NonInteractive", "-Command", command],
                   input=text, text=True, encoding="utf-8", check=True,
                   creationflags=subprocess.CREATE_NO_WINDOW)

def main():
    parser = argparse.ArgumentParser()
    parser.add_argument("--model", required=True)
    parser.add_argument("--device", type=int, default=None)
    parser.add_argument("--seconds", type=int, default=0, help="Optional maximum recording time; 0 means no limit")
    parser.add_argument("--whisper-model", default=None)
    args = parser.parse_args()
    SetLogLevel(-1)
    if args.whisper_model:
        from faster_whisper import WhisperModel
        model = WhisperModel(args.whisper_model, device="cpu", compute_type="int8")
    else:
        model = Model(args.model)
    root = tk.Tk()
    root.title("Cece - laptop voice prototype")
    root.geometry("720x700")
    status = tk.StringVar(value="Ready. Click Start conversation, then speak.")
    heard = tk.StringVar(value="")
    answer = tk.StringVar(value="")
    ttk.Label(root, text="Cece", font=("Segoe UI", 20, "bold")).pack(pady=8)
    devices = [(i, info["name"].replace("\r", " ").replace("\n", " ") +
               " (" + sd.query_hostapis(info["hostapi"])["name"] + ")")
               for i, info in enumerate(sd.query_devices()) if info["max_input_channels"] > 0]
    names = [f"{i}: {name}" for i, name in devices]
    choice = ttk.Combobox(root, values=names, state="readonly", width=70)
    choice.pack(pady=4)
    requested = next((i for i, (idx, _) in enumerate(devices) if idx == args.device), None)
    preferred = next((i for i, (_, name) in enumerate(devices)
                      if "microphone array" in name.lower() and "wdm-ks" in name.lower()), None)
    default = next((i for i, (idx, _) in enumerate(devices) if idx == sd.default.device[0]), 0)
    selected = requested if requested is not None else (preferred if preferred is not None else default)
    if names:
        choice.current(selected)
    ttk.Label(root, textvariable=status, wraplength=520).pack(pady=4)
    ttk.Label(root, textvariable=heard, wraplength=520).pack(pady=4)
    ttk.Label(root, textvariable=answer, wraplength=520).pack(pady=4)
    button = ttk.Button(root, text="Start conversation")
    button.pack(pady=12)
    controls = ttk.LabelFrame(root, text="Gazebo movement (experimental)")
    controls.pack(pady=6)
    controls_status = tk.StringVar(value="Simulation test gaits: feet slide; physical walking is unverified.")
    ttk.Label(controls, textvariable=controls_status).grid(row=3, column=0, columnspan=3)

    auto_watch = threading.Event()

    def watch_autonomy():
        while auto_watch.is_set():
            try:
                with urllib.request.urlopen("http://127.0.0.1:8768/status", timeout=3) as result:
                    data = json.load(result)
                root.after(0, controls_status.set, "Autonomous: " + data["message"])
                if not data["autonomous_running"]:
                    auto_watch.clear()
                    break
            except Exception as exc:
                root.after(0, controls_status.set, "Autonomous status unavailable: " + str(exc))
                auto_watch.clear()
                break
            time.sleep(1.5)

    def command_motion(command):
        def send():
            try:
                request = urllib.request.Request("http://127.0.0.1:8768/ask",
                    data=command.encode("utf-8"), method="POST",
                    headers={"Content-Type": "text/plain; charset=utf-8"})
                with urllib.request.urlopen(request, timeout=15) as result:
                    message = result.read().decode("utf-8")
                root.after(0, controls_status.set, message)
                if command == "start autonomous" and message.startswith("Autonomous simulation requested"):
                    if not auto_watch.is_set():
                        auto_watch.set()
                        threading.Thread(target=watch_autonomy, daemon=True).start()
                elif command == "stop":
                    auto_watch.clear()
            except Exception as exc:
                root.after(0, controls_status.set, "Movement unavailable: " + str(exc))
        threading.Thread(target=send, daemon=True).start()

    ttk.Button(controls, text="Forward", command=lambda: command_motion("move forward 2 steps")).grid(row=0, column=1, padx=4, pady=2)
    ttk.Button(controls, text="Left", command=lambda: command_motion("move left 2 steps")).grid(row=1, column=0, padx=4, pady=2)
    ttk.Button(controls, text="Stop", command=lambda: command_motion("stop")).grid(row=1, column=1, padx=4, pady=2)
    ttk.Button(controls, text="Right", command=lambda: command_motion("move right 2 steps")).grid(row=1, column=2, padx=4, pady=2)
    ttk.Button(controls, text="Back", command=lambda: command_motion("move backward 2 steps")).grid(row=2, column=1, padx=4, pady=2)
    ttk.Button(root, text="Start autonomous simulation", command=lambda: command_motion("start autonomous")).pack(pady=4)
    robot = ttk.LabelFrame(root, text="Send a message to a real Cece over local Wi-Fi")
    robot.pack(pady=6, fill="x", padx=12)
    ttk.Label(robot, text="Robot address").grid(row=0, column=0, sticky="w")
    robot_url = tk.StringVar(value="http://")
    ttk.Entry(robot, textvariable=robot_url, width=27).grid(row=0, column=1, padx=3)
    ttk.Label(robot, text="Token").grid(row=0, column=2)
    robot_token = tk.StringVar()
    ttk.Entry(robot, textvariable=robot_token, show="*", width=20).grid(row=0, column=3, padx=3)
    robot_speaker = tk.BooleanVar(value=True)
    ttk.Checkbutton(robot, text="Play reply on robot speaker (experimental)", variable=robot_speaker).grid(row=4, column=0, columnspan=4, sticky="w")
    robot_mic = tk.BooleanVar(value=False)
    ttk.Checkbutton(robot, text="Use robot microphone (experimental)", variable=robot_mic).grid(row=3, column=0, columnspan=4, sticky="w")
    robot_message = tk.StringVar()
    ttk.Entry(robot, textvariable=robot_message, width=55).grid(row=1, column=0, columnspan=3, padx=3, pady=4, sticky="ew")
    remote_status = tk.StringVar(value="Connect the robot and enable remote messages first.")
    ttk.Label(robot, textvariable=remote_status, wraplength=620).grid(row=2, column=0, columnspan=4)
    def send_remote():
        url, token, message = robot_url.get(), robot_token.get(), robot_message.get()
        remote_status.set("Sending...")
        def worker():
            try:
                result = send_robot_message(url, token, message)
                root.after(0, remote_status.set, result)
            except Exception as exc:
                root.after(0, remote_status.set, "Robot message failed: " + str(exc))
        threading.Thread(target=worker, daemon=True).start()
    ttk.Button(robot, text="Send", command=send_remote).grid(row=1, column=3, padx=3)
    distance_status = tk.StringVar(value="Robot range: not connected")
    ttk.Label(robot, textvariable=distance_status).grid(row=5, column=0, columnspan=4, sticky="w")
    telemetry_busy = False
    def poll_robot():
        nonlocal telemetry_busy
        url, token = robot_url.get().strip(), robot_token.get()
        if not telemetry_busy and url not in ("", "http://") and len(token) >= 16:
            telemetry_busy = True
            def worker():
                nonlocal telemetry_busy
                try:
                    data = json.loads(robot_request(url, token, "/status", timeout=4))
                    cm = data.get("range_cm")
                    message = "Robot range: no valid echo" if cm is None else f"Robot range: {cm:.1f} cm"
                    root.after(0, distance_status.set, message)
                except Exception:
                    root.after(0, distance_status.set, "Robot range: unavailable")
                finally:
                    telemetry_busy = False
            threading.Thread(target=worker, daemon=True).start()
        root.after(2500, poll_robot)
    root.after(2500, poll_robot)
    stop_event = threading.Event()
    running = False

    def update(var, value):
        root.after(0, var.set, value)

    def finished():
        nonlocal running
        running = False
        button.config(text="Start conversation", state="normal")

    def work(device, device_name, remote_url, remote_token, use_robot_mic, use_robot_speaker):
        try:
            while not stop_event.is_set():
                update(status, "Listening... speak when ready.")
                if use_robot_mic:
                    text, peak = record_robot(model, remote_url, remote_token, bool(args.whisper_model), stop_event)
                else:
                    text, peak = record(model, device, args.seconds, bool(args.whisper_model), device_name, stop_event)
                if stop_event.is_set():
                    break
                if not text:
                    update(status, "I didn't catch that. Listening again...")
                    continue
                update(heard, "You: " + text + f"   [mic level: {peak}]")
                update(status, "Thinking...")
                if remote_url and remote_url != "http://":
                    send_robot_message(remote_url, remote_token, oled_excerpt(text))
                    response = ask_local_bridge(text)
                    send_robot_message(remote_url, remote_token, oled_excerpt(response))
                else:
                    response = ask_esp(text)
                update(answer, "Cece: " + response)
                if stop_event.is_set():
                    break
                update(status, "Speaking...")
                if remote_url and remote_url != "http://" and use_robot_speaker:
                    speak_mirrored(response, remote_url, remote_token)
                else:
                    speak(response)
            update(status, "Conversation stopped.")
        except Exception as exc:
            update(status, "Error: " + str(exc))
        finally:
            root.after(0, finished)

    def toggle():
        nonlocal running
        if running:
            stop_event.set()
            button.config(text="Stopping...", state="disabled")
            return
        index = choice.current()
        if index < 0 and not robot_mic.get():
            status.set("Choose a microphone first.")
            return
        device = devices[index] if index >= 0 else (None, None)
        stop_event.clear()
        running = True
        button.config(text="Stop conversation")
        threading.Thread(target=work, args=(*device, robot_url.get().strip(), robot_token.get(), robot_mic.get(), robot_speaker.get()), daemon=True).start()

    def close():
        auto_watch.clear()
        stop_event.set()
        root.destroy()

    button.config(command=toggle)
    root.protocol("WM_DELETE_WINDOW", close)
    root.mainloop()

if __name__ == "__main__":
    main()
