javadtaghia/cece-the-robot/experiments/cece/firmware/CeceBench/pc_bridge/server.py

"""Cece's prototype text bridge with an optional Gazebo-only gait."""
import argparse
import json
import os
import re
import subprocess
import threading
import time
from pathlib import Path
import urllib.error
import urllib.parse
import urllib.request
from http.server import BaseHTTPRequestHandler, ThreadingHTTPServer

motion_lock = threading.Lock()
autonomy_process = None
SIM_DIR = Path(__file__).resolve().parents[3] / "ros2_sim"
STOP_FILE = SIM_DIR / "generated" / ".cece_stop"
AUTO_STOP = SIM_DIR / "generated" / ".cece_auto_stop"

def requested_steps(prompt):
    match = re.search(r"\b(\d+|(?:one|two|three|four|five|six|seven|eight|nine|ten|eleven|twelve|thirteen|fourteen|fifteen|sixteen|seventeen|eighteen|nineteen|twenty|thirty|forty|fifty|sixty|seventy|eighty|ninety)(?:[ -](?:one|two|three|four|five|six|seven|eight|nine))?)\s+steps?\b", prompt, re.I)
    if not match:
        return None
    value = match.group(1).lower()
    if value.isdigit():
        return int(value)
    numbers = dict(zip(("one","two","three","four","five","six","seven","eight","nine",
                        "ten","eleven","twelve","thirteen","fourteen","fifteen","sixteen",
                        "seventeen","eighteen","nineteen","twenty"),
                       range(1, 21)))
    numbers.update({"thirty": 30, "forty": 40, "fifty": 50, "sixty": 60,
                    "seventy": 70, "eighty": 80, "ninety": 90})
    return sum(numbers[word] for word in re.split(r"[ -]", value))

def start_gait(steps, phase_seconds=0.8, direction="forward"):
    STOP_FILE.parent.mkdir(exist_ok=True)
    STOP_FILE.unlink(missing_ok=True)
    count = 0 if steps is None else steps
    if direction not in ("forward", "backward", "left", "right"):
        raise ValueError("Invalid simulation direction")
    partition = os.environ.get("CECE_GZ_PARTITION", "")
    if partition and not re.fullmatch(r"[A-Za-z0-9_-]+", partition):
        raise ValueError("Invalid Gazebo partition")
    prefix = f"export GZ_PARTITION={partition} && " if partition else ""
    process = subprocess.Popen(["wsl", "-d", "Ubuntu", "--", "bash", "-c",
        f"{prefix}source /opt/ros/jazzy/setup.bash && exec /usr/bin/python3 walk_controller.py --steps {count} --phase-seconds {phase_seconds} --direction {direction}"],
        cwd=SIM_DIR,
        stdout=subprocess.DEVNULL, stderr=subprocess.DEVNULL)
    # Detect immediate launch errors before reporting that the request started.
    time.sleep(3)
    if process.poll() is not None:
        raise RuntimeError("Gazebo gait controller failed to start")
    def watch():
        try:
            process.wait()
        finally:
            motion_lock.release()
    threading.Thread(target=watch, daemon=True).start()

def start_autonomy():
    global autonomy_process
    STOP_FILE.parent.mkdir(exist_ok=True)
    STOP_FILE.unlink(missing_ok=True)
    AUTO_STOP.unlink(missing_ok=True)
    partition = os.environ.get("CECE_GZ_PARTITION", "")
    if partition and not re.fullmatch(r"[A-Za-z0-9_-]+", partition):
        raise ValueError("Invalid Gazebo partition")
    prefix = f"export GZ_PARTITION={partition} && " if partition else ""
    log = (STOP_FILE.parent / "autonomous.log").open("w", encoding="utf-8")
    try:
        process = subprocess.Popen(["wsl", "-d", "Ubuntu", "--", "bash", "-c",
            f"{prefix}source /opt/ros/jazzy/setup.bash && exec /usr/bin/python3 autonomous.py"],
            cwd=SIM_DIR, stdout=log, stderr=subprocess.STDOUT)
    except Exception:
        log.close()
        raise
    autonomy_process = process
    def watch():
        try:
            process.wait()
        finally:
            log.close()
            motion_lock.release()
    threading.Thread(target=watch, daemon=True).start()


def json_request(url, *, payload=None, headers=None, timeout=30):
    data = None if payload is None else json.dumps(payload).encode("utf-8")
    request = urllib.request.Request(url, data=data, headers=headers or {},
                                     method="GET" if data is None else "POST")
    with urllib.request.urlopen(request, timeout=timeout) as response:
        return json.load(response)

def weather_description(code, daytime):
    if code == 0: return "sunny" if daytime else "clear"
    if code in (1, 2): return "partly cloudy"
    if code == 3: return "cloudy"
    if code in (45, 48): return "foggy"
    if code in (51, 53, 55, 56, 57): return "drizzly"
    if code in (61, 63, 65, 66, 67, 80, 81, 82): return "rainy"
    if code in (71, 73, 75, 77, 85, 86): return "snowy"
    if code in (95, 96, 99): return "stormy"
    return "unknown"

def get_weather(city, latitude, longitude):
    params = urllib.parse.urlencode({"latitude": latitude, "longitude": longitude,
        "current": "temperature_2m,weather_code,is_day", "timezone": "auto"})
    result = json_request("https://api.open-meteo.com/v1/forecast?" + params)
    current = result["current"]
    description = weather_description(int(current["weather_code"]), bool(current["is_day"]))
    return f"In {city}, it is {description} and {round(current['temperature_2m'])} degrees Celsius."

def openai_answer(prompt, model, key):
    if not key:
        raise ValueError("OPENAI_API_KEY is not configured on this computer")
    data = json_request("https://api.openai.com/v1/responses", payload={
        "model": model, "reasoning": {"effort": "none"},
        "instructions": "You are Cece, a small friendly robot. Answer briefly. "
                        "Do not claim to move, see, hear, or know current weather.",
        "input": prompt, "max_output_tokens": 120, "store": False,
    }, headers={"Authorization": "Bearer " + key, "Content-Type": "application/json"},
       timeout=60)
    parts = [part.get("text", "") for item in data.get("output", [])
             if item.get("type") == "message" for part in item.get("content", [])
             if part.get("type") == "output_text"]
    answer = " ".join(parts).strip()
    if not answer:
        raise ValueError("OpenAI returned no text")
    return answer

def ollama_answer(prompt, model):
    data = json_request("http://127.0.0.1:11434/api/generate", payload={
        "model": model, "stream": False, "prompt": prompt, "think": False,
        "options": {"num_predict": 80, "num_ctx": 1024}},
        headers={"Content-Type": "application/json"}, timeout=60)
    return data["response"].strip()

def atbots_answer(prompt, model):
    # AtBots handles consent, credential storage, refresh and profile locking.
    from atbots.config import ProviderConfig
    from atbots.providers.authenticated import AuthenticatedProvider
    row = ProviderConfig(name="cece", kind="chatgpt", model=model,
                         egress_class="remote", auth_profile="default")
    provider = AuthenticatedProvider(row, capability_refs=[], retries=0)
    result = provider.complete(system="You are Cece, a small friendly robot. Answer briefly. "
                               "Do not claim to move, see, hear, or know current weather.",
                               prompt=prompt)
    return result.text.strip()

def reply(prompt, config):
    # Keep motor commands away from model text: walking is not yet calibrated.
    if getattr(config, "sim_motion", False) and re.search(r"\b(?:stop|halt)\b", prompt, re.I):
        if not motion_lock.locked():
            return "The simulated gait is not running."
        STOP_FILE.parent.mkdir(exist_ok=True)
        AUTO_STOP.touch()
        STOP_FILE.touch()
        return "Stopping simulated motion."
    if re.search(r"\b(?:autonomous|autonomy)\b", prompt, re.I):
        if not getattr(config, "sim_motion", False):
            return "Autonomous mode is available only in simulation."
        if not motion_lock.acquire(blocking=False):
            return "The simulated gait is already running."
        try:
            start_autonomy()
        except Exception:
            motion_lock.release()
            raise
        return "Autonomous simulation requested; waiting for sensor data."
    if re.search(r"\b(?:walk|move|step|turn|forward|backward)\b", prompt, re.I):
        if getattr(config, "sim_motion", False):
            direction = next((d for pattern, d in ((r"\b(?:backward|backwards|back)\b", "backward"),
                (r"\bleft\b", "left"), (r"\bright\b", "right"))
                if re.search(pattern, prompt, re.I)), "forward")
            steps = requested_steps(prompt)
            if steps is not None and steps < 1:
                return "Please ask for at least one step."
            if not motion_lock.acquire(blocking=False):
                return "The simulated gait is already running."
            try:
                if re.search(r"\b(?:fast|faster|quickly)\b", prompt, re.I):
                    start_gait(steps, 0.4, direction)
                else:
                    start_gait(steps, direction=direction)
            except Exception:
                motion_lock.release()
                raise
            return (f"Requested {steps} simulated {direction} steps." if steps is not None
                    else f"Moving {direction} in simulation until you say stop.")
        return "I cannot walk yet. My motors need calibration and a tested gait."
    if re.search(r"\b(?:weather|temperature|forecast)\b", prompt, re.I):
        return get_weather(config.city, config.latitude, config.longitude)
    if config.provider == "openai":
        return openai_answer(prompt, config.model, os.environ.get("OPENAI_API_KEY"))
    if config.provider == "atbots":
        return atbots_answer(prompt, config.model)
    return ollama_answer(prompt, config.model)

class Handler(BaseHTTPRequestHandler):
    def do_GET(self):
        if self.path != "/status":
            self.send_error(404)
            return
        process = autonomy_process
        running = process is not None and process.poll() is None
        message = "Autonomous simulation stopped."
        if process is not None:
            try:
                lines = (STOP_FILE.parent / "autonomous.log").read_text(encoding="utf-8", errors="replace").splitlines()
                messages = [line for line in lines if line.startswith(("Waiting for camera", "Clear ", "Obstacle ", "No clear route", "Autonomous simulation stopped"))]
                if messages:
                    message = messages[-1]
                if not running and message != "Autonomous simulation stopped":
                    message = "Autonomous simulation ended. Last status: " + message
            except OSError:
                message = "Waiting for autonomous status." if running else message
        data = json.dumps({"autonomous_running": running, "message": message}).encode("utf-8")
        self.send_response(200)
        self.send_header("Content-Type", "application/json")
        self.send_header("Content-Length", str(len(data)))
        self.end_headers()
        self.wfile.write(data)

    def do_POST(self):
        if self.path != "/ask":
            self.send_error(404)
            return
        try:
            size = int(self.headers.get("Content-Length", "0"))
            if size < 1 or size > 800:
                self.send_error(413)
                return
            prompt = self.rfile.read(size).decode("utf-8").strip()
            if not prompt or len(prompt) > 200:
                self.send_error(400)
                return
            response = reply(prompt, self.server.config).encode("utf-8")[:1000]
            self.send_response(200)
            self.send_header("Content-Type", "text/plain; charset=utf-8")
            self.send_header("Content-Length", str(len(response)))
            self.end_headers()
            self.wfile.write(response)
        except Exception as exc:
            self.send_error(502, "Cece service unavailable")
            # Never log request headers or the API key.
            print("Cece service error:", type(exc).__name__, flush=True)

def main():
    parser = argparse.ArgumentParser(description=__doc__)
    parser.add_argument("--listen", default="127.0.0.1")
    parser.add_argument("--port", type=int, default=8765)
    parser.add_argument("--provider", choices=("atbots", "openai", "ollama"), default="atbots")
    parser.add_argument("--model", default=None)
    parser.add_argument("--city", default="Sydney")
    parser.add_argument("--latitude", type=float, default=-33.8688)
    parser.add_argument("--longitude", type=float, default=151.2093)
    parser.add_argument("--sim-motion", action="store_true",
                        help="Enable experimental Gazebo gait; never drives physical servos")
    args = parser.parse_args()
    if args.model is None:
        args.model = "qwen3:1.7b" if args.provider == "ollama" else "gpt-6-luna"
    server = ThreadingHTTPServer((args.listen, args.port), Handler)
    server.config = args
    print(f"Cece bridge on {args.listen}:{args.port}; {args.provider} {args.model}", flush=True)
    server.serve_forever()

if __name__ == "__main__":
    main()
