javadtaghia/cece-the-robot/(commit log)

2026-10-31 Consolidate Cece robot project and prototype studies
2026-10-31 Add simulation controls and experimental sensor models
2026-10-31 Show live autonomous sensor status
2026-10-31 Add live Gazebo robot camera viewer
2026-10-31 Prototype Wi-Fi robot audio and telemetry
2026-11-01 Add isolated Cece 2 four-servo speed study and validated candidate gait
2026-11-01 Add FreeCAD Cece 2 assembly and isolated live Gazebo viewer
2026-11-03 Add Due SG90 bench tests and mirrored four-servo gait firmware
2026-11-07 Save light PLA print project for Cece ESP support
2026-11-08 Save and send revised Cece support PLA print
2026-11-08 Restore open Cece carrier and extend only side grips to 20 mm
2026-11-08 Preview 5 mm raised Cece ESP assembly and expose head conflicts
2026-11-08 Add deeper Cece ESP slide channels at original camera height
2026-11-08 Revise Cece ESP dimensions and add offset camera support flap
2026-11-08 Save R9 light PLA print project
2026-11-08 Deepen Cece carrier R10 and clear central frame ridge
2026-11-08 Open Cece carrier R11 cap for board pin access
2026-11-08 Remove Cece carrier R12 ledge beside board
2026-11-08 Route Cece carrier R13 frame around the ESP board
2026-11-08 Shift screenshot-right Cece carrier shoulder outward 3 mm
2026-11-08 Save R15 light PLA H2S print project
2026-11-08 Reinforce Cece R16 USB-end upright and frame roots
2026-11-08 Save reinforced R16 PLA print profile
2026-11-08 Record R16 printer startup
2026-11-09 Add HC-SR04 ultrasonic wiring to S3 KiCad schematic
2026-11-09 Place ultrasonic circuit on main Cece wiring sheet
2026-11-11 Add OLED to the combined wiring sheet and save carrier assemblies and previews
2026-11-11 Guide users to Cece CAD, printable parts, wiring, firmware and simulation
2026-11-14 Add phone-controlled walking and individual servo positions to S3 media firmware
2026-11-14 Match S3 gait, phone controls and wiring to the installed servo sockets
2026-11-14 Lower Cece's feet gradually and match hip rotation to the installed servos
2026-11-14 Calibrate and save a separate neutral position for each joint
2026-11-14 Calibrate the right hip around the requested +30 command with half travel
2026-11-14 Document the 14 November walking milestone, servo calibration and charger choices
2026-11-14 Back up Cece's board-reported walking calibration for replacement controllers
